Abdulrahuf7775/FinalYearProject/turnitin_report/DESIGN AND IMPLEMENTATION OF A MULTI-SENSOR SOIL MONITORING AND LORA COMMUNICATION SYSTEM FOR PRECISION FARMING APPLICATIONS (1).pdf

SEET-Mechatronic Engineering

Final Year Projects 2026

MCE 599

## DESIGN AND IMPLEMENTATION OF A MULTI-SENSOR SOIL MONITORING AND LORA COMMUNICATION SYSTEM FOR PR…

# Abdulrauf Abdulrauf Olasunkanmi 2021/1/79550ET

Document Details

Submission ID
trn:oid:::1:3657835644

Submission Date
Sep 23, 2026, 1:09 PM GMT+1

Download Date
Sep 25, 2026, 6:26 PM GMT+1

File Name
DESIGN_AND_IMPLEMENTATION_OF_A_MULTI-SENSOR_SOIL_MONITORING_AND_LORA_COMMU….docx

File Size

### 4.0 MB

### 71 Pages

15,280 Words

87,166 Characters

Page 1 of 77 - Cover Page | Submission ID trn:oid:::1:3657835644
Page 1 of 77 - Cover Page | Submission ID trn:oid:::1:3657835644

## 5% Overall Similarity

The combined total of all matches, including overlapping sources, for each database.
Match Groups

### 52 Not Cited or Quoted 3%

Matches with neither in-text citation nor quotation marks

### 26 Missing Quotations 1%

Matches that are still very similar to source material

### 1 Missing Citation 0%

Matches that have quotation marks, but no in-text citation

### 0 Cited and Quoted 0%

Matches with in-text citation present, but no quotation marks

Top Sources

3% | Internet sources
3% | Publications
1% | Submitted works (Student Papers)
Page 2 of 77 - Integrity Overview | Submission ID trn:oid:::1:3657835644
Page 2 of 77 - Integrity Overview | Submission ID trn:oid:::1:3657835644

Match Groups

### 52 Not Cited or Quoted 3%

Matches with neither in-text citation nor quotation marks

### 26 Missing Quotations 1%

Matches that are still very similar to source material

### 1 Missing Citation 0%

Matches that have quotation marks, but no in-text citation

### 0 Cited and Quoted 0%

Matches with in-text citation present, but no quotation marks

Top Sources

3% | Internet sources
3% | Publications
1% | Submitted works (Student Papers)

Top Sources

The sources with the highest number of matches within the submission. Overlapping sources will not be displayed.

### 1 Internet

www.mdpi.com (https://www.mdpi.com/1424-8220/26/14/4381) | <1%

### 2 Publication

R.K. Naresh, Rajan Bhatt, Krishan K. Verma, Hari Om Katiyar, Arun Kumar, Mauro … (https://doi.org/10.1201/9781042052547) <1%

### 3 Publication

S. Kannadhasan, P. Sivakumar, Anegagregn Gashaw Ferede, Abraham Melkie Ted… (https://doi.org/10.1201/9781003598312) <1%

### 4 Publication

Md. Najmul Mowla, Neazmul Mowla, A. F. M. Shahen Shah, Khaled M. Rabie, Thok… (https://doi.org/10.1109/ACCESS.2023.3346299) <1%

### 5 Internet

www2.mdpi.com (https://www2.mdpi.com/2071-1050/14/2/827) | <1%

### 6 Internet

arxiv.org (https://arxiv.org/html/2409.11200v1) | <1%

### 7 Internet

ijaseit.insightsociety.org (https://ijaseit.insightsociety.org/index.php/ijaseit/article/view/18836) | <1%

### 8 Student papers

IT University of Copenhagen | <1%

### 9 Internet

www.suaire.sua.ac.tz (https://www.suaire.sua.ac.tz/server/api/core/bitstreams/3a597491-25bc-4f92-a3c6-7f9c52a5762f/content) | <1%

### 10 Publication

Suman Lata Tripathi, Om Prakash Kumar, Allwin Devaraj Stalin, Tanweer Ali. "Inn… (https://doi.org/10.1201/9781003724988) | <1%
Page 3 of 77 - Integrity Overview | Submission ID trn:oid:::1:3657835644
Page 3 of 77 - Integrity Overview | Submission ID trn:oid:::1:3657835644

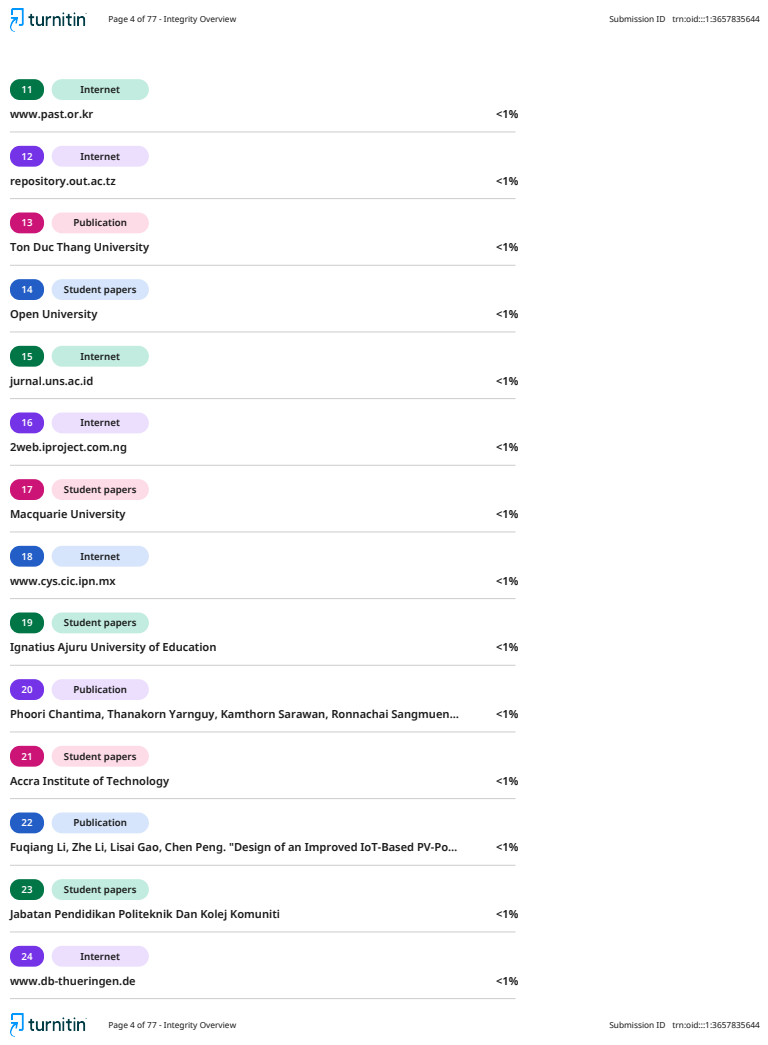
[picture p24: page 4]
11 Internet; www.past.or.kr; 12 Internet; repository.out.ac.tz; 13 Publication; Ton Duc Thang University; 14 Student papers; Open University; 15 Internet; jurnal.uns.ac.id; 16 Internet; 2web.iproject.com.ng; 17 Student papers; Macquarie University; 18 Internet; www.cys.cic.ipn.mx; 19 Student papers; Ignatius Ajuru University of Education; 20 Publication; Phoori Chantima, Thanakorn Yarnguy, Kamthorn Sarawan, Ronnachai Sangmuen…; 21 Student papers; Accra Institute of Technology; 22 Publication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

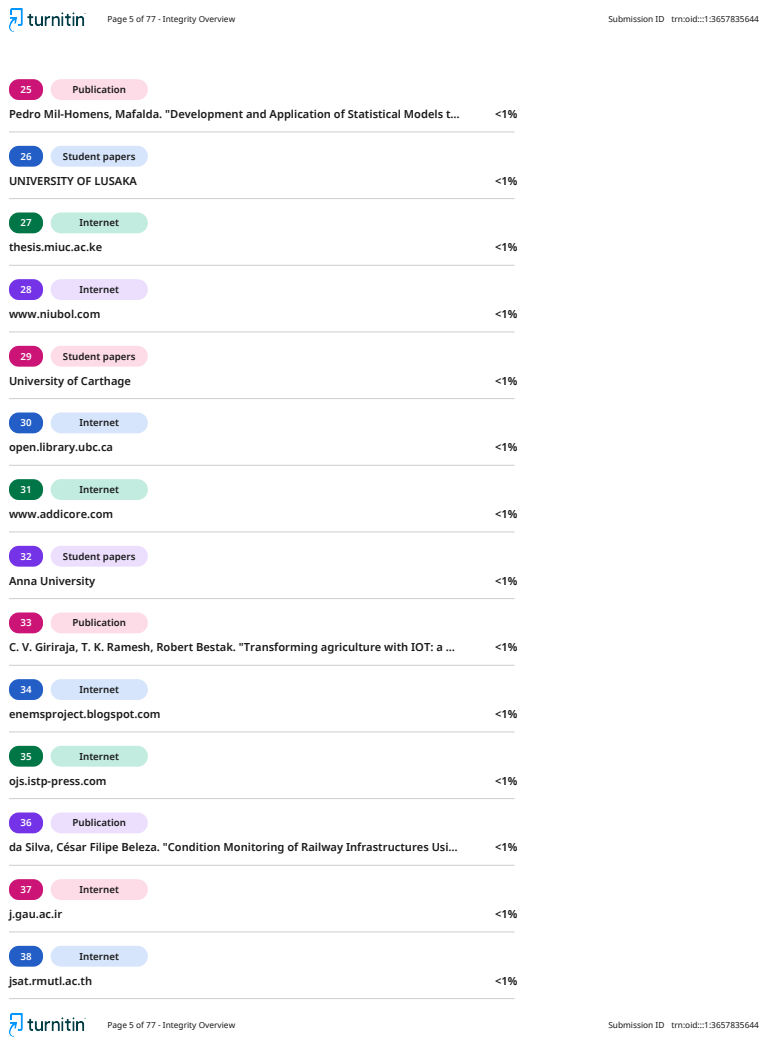
[picture p25: page 5]
25 Publication; Pedro Mil-Homens, Mafalda. "Development and Application of Statistical Models t…; 26 Student papers; UNIVERSITY OF LUSAKA; 27 Internet; thesis.miuc.ac.ke; 28 Internet; www.niubol.com; 29 Student papers; University of Carthage; 30 Internet; open.library.ubc.ca; 31 Internet; www.addicore.com; 32 Student papers; Anna University; 33 Publication; C. V. Giriraja, T. K. Ramesh, Robert Bestak. "Transforming agriculture with IOT: a …; 34 Internet; enemsproject.blogspot.com; 35 Internet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

### 39 Internet

mdpi-res.com (https://mdpi-res.com/d_attachment/electronics/electronics-11-00943/article_deploy/electronics-11-00943.pdf) | <1%

### 40 Internet

sciendo.com (https://sciendo.com/issue/EBTJ/1/4) | <1%

### 41 Internet

www.hackster.io (https://www.hackster.io/Klinsman21/two-arduinos-communicating-at-3km-distance-88fa0f) | <1%

### 42 Publication

Dave Emmanuel V. Nuada, Jerald M. Velonta, Christian Neri G. Tuazon, Jimuel Nyl… (https://doi.org/10.11591/ijeecs.v40.i3.pp1539-1548) | <1%
Page 6 of 77 - Integrity Overview | Submission ID trn:oid:::1:3657835644
Page 6 of 77 - Integrity Overview | Submission ID trn:oid:::1:3657835644

1

CHAPTER ONE

### 1.0 INTRODUCTION

### 1.1 Background of the Study

Agriculture is one of the key foundations of human civilisation. It helps to ensure food security,

economic growth and livelihoods globally. The Food and Agriculture Organisation of the United

Nations (“The State of Food and Agriculture 2025,” 2025) reports that the agriculture sector is a

source of employment for over two and a half billion people worldwide and the backbone of the

economies of developing countries. In sub-Saharan Africa the performance of agriculture has a

direct impact on the national levels of food sufficiency and poverty. But, with the population

explosion, climatic changes, soil degradation, and mismanagement of resources, there are

increasing challenges in agriculture(Singh et al., 2022).

Monitoring and management of soil health is important for food production, and many farming

communities are still not precise and effective at monitoring and managing soil conditions (Khanal

et al., 2024; Shahab et al., 2025). The farmers use traditional practices of soil sampling, laboratory

testing and farmer observation on a periodic basis to aid in irrigation and fertiliser decision-

making. All these | methods are time-consuming, | expensive, | and | unable | to | measure the soil

conditions at various locations within a field (Pawar & Deosarkar, 2023).This results in over-

irrigating or under-fertilising, which wastes water and chemicals for farmers. This also results in

increased production expenses, soil erosion, and harmful environmental impacts such as soil

pollution from nutrient run-off into water bodies (Khanal et al., 2024). In particular, many farmers

in developing areas are still using these antiquated techniques.

The problem of imprecise soil management can be solved by the concept of precision agriculture

with the help of Internet of Things (IoT) and Wireless Sensor Network (WSN) (Almufareh et al.,

1

16

2

2

33 35

Page 7 of 77 - Integrity Submission | Submission ID trn:oid:::1:3657835644
Page 7 of 77 - Integrity Submission | Submission ID trn:oid:::1:3657835644

2

2024; | Arshad | et al., 2022; | Križanović | et al., 2023). It employs real-time measurement and

monitoring of soil moisture, soil temperature, nutrient content and other variables to inform on-

site and time variable management of all production inputs. This is a substitute for blanket

practices, which are substituted with targeted interventions according to specific field conditions

(Placidi et al., 2021). These soil measurements are collected and transmitted by a sensor-based

system that utilises the Internet of Things (IoT), enabling timely decision-making by farmers and

systems to support them. It has been found that irrigation and fertilisation management based on

data can reduce water consumption by 20–40 percent and improve crop yields by 10–25 percent

over conventional practices (Placidi et al., 2021; Khanal et al., 2024). Several IOT soil monitoring

platforms have been designed and tested in the studies and found to be technically feasible (Arshad

et al., 2022).

However, there are still many challenges to be addressed in current soil monitoring systems using

IoT, particularly in remote and rural fields. Many of the solutions available rely on wireless

connectivity, either Wi-Fi or cellular; such connectivity is not always available or reliable in many

developing countries (Sen et al., 2024). Most of the sensors measure a single soil parameter, which

limits the ability to obtain a comprehensive picture of soil conditions required for optimal precision

farming decisions making (Pamungkas et al., 2023). One of the drawbacks is that most of the low-

cost systems lack GPS-based(Global Positioning System) spatial tagging features, which create

geo-referenced soil health maps useful for targeted application of soil health management

strategies for crop management (Pawar & Deosarkar, 2023). All these challenges make it difficult

for smallholder and remote farmers to obtain timely, comprehensive soil information.

The aim of this project is to develop a multi-sensor soil monitoring and LoRa communication

system to overcome these challenges for precision farming. The system is based on the use of an

2

10

Page 8 of 77 - Integrity Submission | Submission ID trn:oid:::1:3657835644
Page 8 of 77 - Integrity Submission | Submission ID trn:oid:::1:3657835644

3

ESP32 | microcontroller | as its central controller, an NPK(Nitrogen, Phosphorus and Potassium)

sensor and a GPS module to collect a wide variety of NPK and environmental parameters at each

of the sensor locations. Data is transmitted wirelessly via LoRa SX1278 transceiver with the

capability to transmit data over ranges in rural areas without requiring any cellular or internet

infrastructure. Each soil measurement is geographically tagged to the GPS module, enabling site-

specific soil health maps to be developed. It is a low cost, low power, plug-and-play system that

is ideal for Smallholder and Farms in Remote Areas in Developing Countries.

### 1.2 Problem Statement

The global population is increasing, arable land is decreasing and climate instability is a problem

for food production systems across the world (Pawar & Deosarkar, 2023). The traditional farming

methods that involve manual soil sampling, visual assessment, and equal water and fertiliser

application are not adaptable to the dynamics and variability of soil properties (Khanal et al.,

2024). They are imprecise, costly and environmentally damaging due to nutrient run-off and soil

compaction. The use of IoT-based precision farming technologies in developing countries and

rural remote regions with low population density is hindered by the continued technological,

infrastructural and financial challenges (Mansoor et al., 2025).

The main issue this project addresses is the lack of a reliable, multi-parameter, infrastructure-

independent soil monitoring system that can work well in remote farming areas. The current low-

cost soil sensors for IoT often use Wi-Fi and/or cellular communication technologies for data

transmission; however, these technologies are frequently unavailable or unreliable in the remote

agricultural areas of developing countries (Arshad et al., 2022; Aldhaheri et al., 2024; Placidi et

al., 2021). The lack of reliable internet infrastructure and power supply remains a primary

bottleneck for precision agriculture in Sub-Saharan Africa, such as in Nigeria (Song et al., 2026;

3

Page 9 of 77 - Integrity Submission | Submission ID trn:oid:::1:3657835644
Page 9 of 77 - Integrity Submission | Submission ID trn:oid:::1:3657835644

4

Lloret et al., 2021). The majority of the sensor nodes that are deployed measure only one soil

characteristic, such as moisture or temperature. Also existing low-cost systems lack GPS-based

geolocation, making it difficult to map soil conditions in a spatial manner which is important for

field zonation for different treatment (Pawar & Deosarkar, 2023). These constraints imply that the

farmers in remote areas are not able to receive the spatiotemporally complete and timely soil

information that they require for the purposes of precision farming.

### 1.3 Aim and Objectives

The aim of this project is to design and implement | multi-sensor | soil | monitoring and LoRa

communication system for precision farming applications.

The objectives of this project include the following:

i. To develop soil sensing nodes which will be able to sense multiple factors.

ii. To develop a wireless communication module utilising LoRa module which will transfer

sensed data to a gateway.

iii. To evaluate the performance of the developed system.

### 1.4 Significance of the Study

This study is a major step forward in the field of precision agriculture by addressing some of the

technological challenges that have hindered the use of soil monitoring devices in rural areas. The

development of a multi-sensor soil monitoring platform that is capable of operating over long

distances without the need of internet access for the farmers from underdeveloped countries is very

crucial. The system gives farmers the information they need to make fast, site-specific decisions

by providing real-time insight into a variety of soil characteristics, such as temperature, humidity,

moisture, and vital nutrients. The results of these studies have consistently shown that yield gains

of 10-25%, water savings of 20-40% and economical savings of 20-30% can be achieved through

2 2

19

Page 10 of 77 - Integrity Submission | Submission ID trn:oid:::1:3657835644
Page 10 of 77 - Integrity Submission | Submission ID trn:oid:::1:3657835644

5

data-driven irrigation and fertilisation management compared to conventional practices (Placidi et

al., 2021).

The proposed technology can help in sustainable agriculture by enabling accurate application of

resources which reduces the chances of fertiliser run-off and reduces unnecessary chemicals and

soil degradation. The advantage of the GPS-based spatial tagging is that detailed soil health maps

can be generated, which is an emerging practice in modern agronomy and is now becoming more

common, the use of precision zone management (Pawar & Deosarkar, 2023). This research offers

fresh insights into how multiple sensor data can be combined with the LoRa communication

system and how this data can be used for predictive analysis using artificial intelligence, providing

researchers and developers with a replicable approach for future smart farming solutions.

### 1.5 Scope of the Study

The project involves the design, development, and testing of a multi-sensor soil monitoring system

with LoRa radio wireless communication to support precision agriculture. Real-time soil moisture,

soil | temperature, | ambient | humidity, and | NPK | nutrient levels | (Nitrogen, Phosphorus, and

Potassium) can be acquired by the system. Each sensor node is equipped with a GPS module for

geographical tagging of collected data. The LoRa SX1278 module enables long-range wireless

data transmission of up to 15 kilometers in rural area, without the need for cellular or Wi-Fi

infrastructure. The system adopts a network topology, where multiple sensor nodes communicate

with a | single | central gateway | that sends and stores sensor data. The system is also designed to

interface with an AI-based predictive module for irrigation and fertilisation decision support.

The LoRa communication range may be reduced in environments with significant physical

obstructions such as dense vegetation or buildings.

1

34

42

Page 11 of 77 - Integrity Submission | Submission ID trn:oid:::1:3657835644
Page 11 of 77 - Integrity Submission | Submission ID trn:oid:::1:3657835644

6

The system | relies | on a rechargeable battery | and solar panel for operation. Extended periods of

cloudy weather or insufficient sunlight may reduce the battery charging efficiency and shorten the

operating time of the sensor node.

The AI-based prediction module relies on data trends over time and may not provide reliable

outputs during the initial period of deployment when insufficient historical data is available.

### 1.6 Organisation of Project

The report of this project is presented in five chapters. The introduction to the study which covers

background, problem statement, aim and objectives, significance, scope and definition of key

terms is presented in Chapter One. In Chapter Two, the literature survey on precision agriculture,

soil monitoring technologies, IoT sensor systems and LoRa communication is presented. The

research methodology used for the development of the system is discussed in Chapter Three, which

includes system architecture, hardware selection, circuit configuration and software

implementation. The results of the system testing and performance evaluation are presented and

discussed in Chapter Four. The report ends | with a summary of findings, | conclusions | and

recommendations for further research in Chapter Five.

### 1.7 Definition of Terms

a) ESP32 (Espressif Systems 32-bit Microcontroller): is a low-power microcontroller with

integrated Wi-Fi and Bluetooth capability, developed by Espressif Systems, that has a dual-

core architecture. The ESP32 is the main component of the soil sensor node in this project,

gathering sensor data, controlling the GPS tagging and arranging LoRa data exchange.

b) | LoRa (Long Range): Long-range, low power wireless | modulation. The long-range

communication capability of 2 to 15 kilometers in a rural area with a low power

13

3

10

26

41

Page 12 of 77 - Integrity Submission | Submission ID trn:oid:::1:3657835644
Page 12 of 77 - Integrity Submission | Submission ID trn:oid:::1:3657835644

7

consumption makes LoRa a perfect solution for agricultural IoT applications in rural areas

without cellular coverage.

c) NPK Sensor: The NPK Sensor is an electronic soil sensor that measures the concentration

of three macronutrient elements (Nitrogen (N), Phosphorus (P), Potassium (K)) in the soil.

These nutrients are | important metrics | for | soil fertility | and | crop health, and real-time

measurement of these nutrients is essential for precision farming and fertiliser application.

d) Precision Agriculture: A farm management strategy that utilises information technology,

sensor networks, and data analytics to optimise field-level agronomic decisions with

respect to crop, soil, and environmental conditions. Precision agriculture aims to maximise

crop yield and resource efficiency by enabling site-specific and time-specific management

of farming inputs.

e) Telemetry: Automatic measurement and wireless transmission of such measurements

from remote sensors to a receiving station for monitoring and analysis.

28

Page 13 of 77 - Integrity Submission | Submission ID trn:oid:::1:3657835644
Page 13 of 77 - Integrity Submission | Submission ID trn:oid:::1:3657835644

8

CHAPTER TWO

### 2.0 LITERATURE REVIEW

### 2.1 Chapter Introduction

The chapter reviews the body of knowledge that is used when designing this project. It starts with

the basics - what precision agriculture is, the relationship between soil health parameters and crop

productivity and how sensor-based systems using IoT technologies have been implemented to

overcome the gap between field condition and farm management. So, the review focuses on the

technology used in the system, which includes wireless sensor networks, wireless LoRa

communication, the ESP32 microcontroller, and the integration of GPS. The chapter ends in a

well-organised review of direct related implementations and a summary of the gaps that the review

identifies.

### 2.2 Precision Agriculture

The term "precision agriculture" gets used loosely, but its core idea is specific: “inputting the

correct input, at the correct rate, at the correct location, at the correct time” (Mansoor et al., 2025).

It is different from traditional farming where a farmer spreads the same amount of water or

fertiliser throughout a field irrespective of the requirement of the different zones in that field

(Almufareh et al., 2024; Mansoor et al., 2025). It was a concept that developed in the 1980s when

GPS was first introduced and when yield-mapping equipment was also available (Lloret et al.,

2021; Mansoor et al., 2025). The cost of precision agriculture and the potential benefits were not

aligned enough to be practically used by many smallholder and mid-scale farms, until the advent

of affordable IoT sensors and wireless communication in the 2010s (Pawar & Deosarkar, 2023;

Song et al., 2026). That barrier cost still exists, and that is the problem that this project addresses.

12

Page 14 of 77 - Integrity Submission | Submission ID trn:oid:::1:3657835644
Page 14 of 77 - Integrity Submission | Submission ID trn:oid:::1:3657835644

9

Data is the key to precision agriculture success. It needs to continually provide spatially referenced

measurements of the variables that control crop performance: soil moisture, temperature,

macronutrient concentrations, pH(Potential of Hydrogen), ambient humidity (Song et al., 2026).

These parameters do not display a consistent pattern throughout a field. Hectares of farm land can

have pockets of high clay portions directly next to well-drained sandy soils, and areas with

inadequate amounts of nitrogen alongside other areas that are sufficiently fertilised. Failure to

acknowledge this variability in a field entirely results in predictably sub-optimal results (Placidi et

al., 2021).

In precision agriculture, the field is subdivided into management zones, with the inputs applied

according to the measured conditions in each zone (Mansoor et al., 2025; Najdenko et al., 2024).

This approach of zones is entirely reliant on the quality and spatial density of the information

provided by the underlying sensors; if the number of sensors is limited or data is sparse or delayed,

the zones are too broad to be considered a significant improvement over the uniform approach

(Mansoor et al., 2025; Song et al., 2026). This is because the frequency of the monitoring system

is as important as the management strategy that is developed on top of the monitoring system

(Khanal et al., 2024; Shahab et al., 2025)

Precision agriculture is considered by | the Food and Agriculture Organization (FAO) | as | a | core

approach to sustainable intensification, which aims to boost agricultural output and food

production on existing farmland without causing additional environmental harm or a

corresponding rise in resource use (FAO, 2025). If the world's population keeps rising towards a

projected 10 billion by 2050 while the amount of productive arable land remains strictly limited

and dwindling, it puts the field in an entirely different light than just farm economics (Pawar &

Deosarkar, 2023; Shahab et al., 2025). It comes to the forefront exactly where the complex issues

2

Page 15 of 77 - Integrity Submission | Submission ID trn:oid:::1:3657835644
Page 15 of 77 - Integrity Submission | Submission ID trn:oid:::1:3657835644

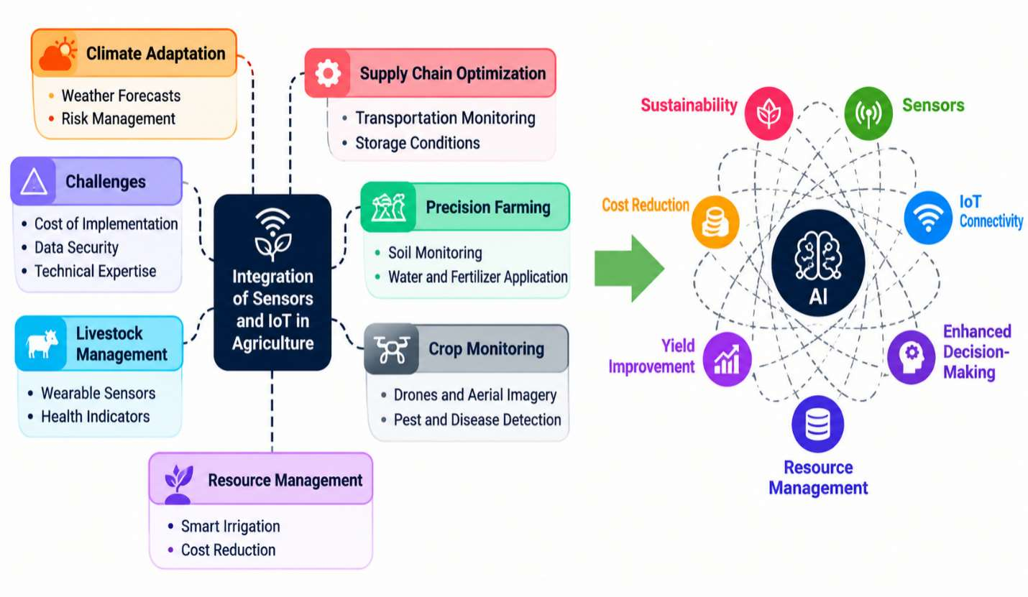
[picture p26: figure]

10

of global food security, environmental sustainability, and agricultural development policy intersect

(FAO, 2025; Mansoor et al., 2025). Consequently, leveraging precision technologies for

sustainable land management is no longer merely a commercial agricultural concern, but a critical

global development priority that underpins efforts to protect ecosystems, adapt to climate

instability, and achieve the United Nations' Sustainable Development Goals (FAO, 2025; Shahab

et al., 2025). Figure 2.1 illustrates | the integration of sensors | and IoT in precision agriculture,

highlighting their role in supporting efficient and data-driven farming practices (Mansoor et al.,

2025).

Figure 2.1 Integration of Sensors and IoT in Precision Agriculture(Mansoor et al., 2025)

### 2.3 Soil Parameters and Their Agronomic Significance

Soil is not an inert growing medium; it is a highly dynamic system, and the parameters that define

its state at any particular time directly affect a crop's productivity (Shahab et al., 2025). Knowing

which parameters are important and why they fluctuate is essential to the design of a precision

37

18

Page 16 of 77 - Integrity Submission | Submission ID trn:oid:::1:3657835644
Page 16 of 77 - Integrity Submission | Submission ID trn:oid:::1:3657835644

11

monitoring system. The following subsections detail the primary variables affecting crop

production that this system aims to monitor.

### 2.3.1 Soil Moisture

Of the variables affecting crop production, water availability is by far the most critical in the short

term. Water and dissolved nutrients are taken up by the roots, and when the water content in the

soil drops below the specific "wilting point" for a plant, growth slows, and yield loss can occur

within days (Chereches et al., 2024). However, excess watering is equally problematic; excessive

moisture in the soil reduces oxygen availability around the roots, leading to anaerobic conditions

that benefit pathogenic bacteria and increase nutrient loss from the soil (Pawar & Deosarkar, 2023).

Traditional irrigation scheduling is generally based on calendar or evapotranspiration estimates,

both of which are merely proxies for what physical sensors can measure. With real-time moisture

data, irrigation can be triggered by current field moisture conditions rather than estimates,

successfully saving water without compromising yield (Sen et al., 2024). To address this

efficiently, recent implementations have successfully utilised low-cost capacitance-based soil

moisture sensors with specialised modelling to accurately read volumetric water content across

various soil types (Placidi et al., 2021).

### 2.3.2 Soil Temperature

Soil temperature affects the germination rates, rooting, efficiency of nutrient uptake, and microbial

activity (Pawar & Deosarkar, 2023; Shahab et al., 2025). For most crops, there is a critical

temperature range before and after which root formation and nutrient uptake are effective, and

higher or lower than this range even with sufficient moisture and nutrient may have negative

impacts on normal plant performance (Shahab et al., 2025). The monitoring of temperature in

Page 17 of 77 - Integrity Submission | Submission ID trn:oid:::1:3657835644
Page 17 of 77 - Integrity Submission | Submission ID trn:oid:::1:3657835644

12

addition to moisture allows a management system to consider these interactions, rather than

assuming they operate independently of each other (Khanal et al., 2024).

### 2.3.3 Ambient Humidity

The relative humidity (RH) of the air above the crop canopy directly influences the crop's

transpiration rate, and consequently, the rate of decrease in soil moisture. Increased ambient

humidity reduces transpiration and water loss, whereas decreased humidity accelerates them

(Placidi et al., 2021). The inclusion of ambient humidity in the sensing suite makes irrigation

scheduling substantially more accurate than relying on soil moisture data alone, as it accounts for

one of the major atmospheric factors contributing to changing field conditions (Khanal et al.,

2024).

Ambient humidity is one of the most important factors that influence the overall evapotranspiration

rate, which is one of the most important factors used for calculating the actual crop water demand

and for scheduling the exact irrigation event (Singh et al., 2022). This ability to monitor variations

in air humidity in addition to temperature, continuously makes the IoT system very "climate-

adaptive," such that it can automatically adapt watering schedules to prevent water stress in plants

due to very dry air (Sen et al., 2024).

Knowledge of the ambient humidity is important for plant physiology, as leaf growth,

photosynthesis and pollination rates may be severely affected by a growth of plants in dry

conditions, leading to the death of delicate plant structures (like sepals or flowers) before reaching

maturity (Placidi et al., 2021). Consequently, feeding real-time humidity data into an automated

decision-making algorithm enables the system to forecast evaporation trends dynamically. This

ensures that the water distributed to the root zone precisely matches the fluctuating atmospheric

12

Page 18 of 77 - Integrity Submission | Submission ID trn:oid:::1:3657835644
Page 18 of 77 - Integrity Submission | Submission ID trn:oid:::1:3657835644

13

demands above ground, optimising resource use while safeguarding crop health (Sen et al., 2024;

Singh et al., 2022).

### 2.3.4 Soil Fertility and Macronutrients (NPK)

Soil fertility is mainly governed by the macronutrients (Nitrogen, Phosphorus ,Potassium) and

each one has a different role in the physiology of the plants. Nitrogen is key to protein production

and vegetative growth, deficiency causes yellowing leaves and slow growth, and excess causes

luxuriant leaves while restricting root and fruit production (Shahab et al., 2025). Phosphorus

stimulates root growth, flowering and seed production, especially in early growth of most crops.

Potassium is involved in water control in plant cells, resistance to diseases and enhancing fruit

quality, and under potassium deficiency plant is highly vulnerable to drought stress (Perdana et

al., 2024). Figure 2.2 illustrates common symptoms associated with nutrient deficiencies in plants,

providing a visual representation of how nutrient imbalance can affect plant development (Shahab

et al., 2025).

The traditional way of assessing NPK is laboratory testing of soil samples, which can take days to

weeks, and requires financial resources that many smallholder farmers in developing countries just

do not have. The readings of electronic NPK sensors based on the ion-selective electrode method

are obtained within seconds. In soil fertility monitoring, the accuracy of electronic multi-sensor

NPK measurements compared to the laboratory results was tested and proven to be sufficient for

implementation in precision farming (Pamungkas et al., 2023).

Page 19 of 77 - Integrity Submission | Submission ID trn:oid:::1:3657835644
Page 19 of 77 - Integrity Submission | Submission ID trn:oid:::1:3657835644

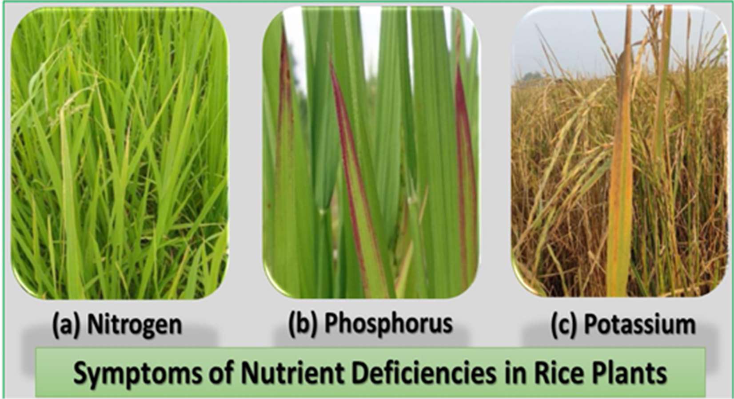
[picture p27: figure]

14

Figure 2.2: Symptoms of Nutrient Deficiencies in Plant (Shahab et al., 2025)

### 2.4 Wireless Sensor Networks in Agriculture

A Wireless Sensor Network consists of | a group of | spatially distributed | sensor | nodes | which

communicate wirelessly to gather and share data (Križanović et al., 2023). Agricultural WSNs

have constraints that are not found in most industrial and urban deployments: power consumption,

since nodes are placed on batteries and are required to power them for a long time without

maintenance (Aldhaheri et al., 2024; Patrizi et al., 2022); long communication range, since the

fields are large (Aldhaheri et al., 2024); and outdoor reliability in the presence of rain, temperature

variation, and dense vegetation (Lloret et al., 2021; Mansoor et al., 2025).

Different WSNs use different communication technology, hence, different constraints can be

satisfied for each type. Wi-Fi achieves high data rates and has a range of tens of metres at best,

and consumes too much power for battery-powered field nodes (Arshad et al., 2022). GSM(Global

System for Mobile Communications) and cellular networks offer range but need infrastructure,

power usage higher than LPWAN (Low-Power Wide-Area Network) and | SIM and | data | costs
(Mansoor | et al., 2025). All of those are not well suited to the range, power efficiency and

infrastructure independence needed for remote agricultural monitoring.

11

8

Page 20 of 77 - Integrity Submission | Submission ID trn:oid:::1:3657835644
Page 20 of 77 - Integrity Submission | Submission ID trn:oid:::1:3657835644

15

This is where low-power wide-area network (LPWAN) technologies come in. They sacrifice data

rate because agricultural sensor data doesn't require it as often, and since it's small packets that are

being sent (Aldhaheri et al., 2024). A soil monitoring node sending a few dozen bytes every few

minutes doesn't need bandwidth; it needs to reach a gateway kilometers away without draining its

battery in a week.

### 2.4.1 LoRa and LoRaWAN Technology

Spread-spectrum modulation technique developed by Semtech, which uses unlicensed sub GHz

frequency bands called LoRa (Long Range). The modulation technique is what makes it special

(Križanović et al., 2023). LoRa employs Chirp Spread Spectrum (CSS) that encodes data into

sweeps of frequencies over a given bandwidth. The received signal level for CSS signals is well

below the noise floor, which is not possible with conventional narrow band modulation (Singh et

al., 2022).

LoRa operates in open, rural areas that either have line of sight or near line of sight between a node

and a gateway and can transmit in the milliwatt power range between 2 and 15 kilometers from a

node to a gateway. In the urban context, range is heavily restricted by the presence of buildings

and roads, whereas it is not in rural conditions, which is pertinent to this context (Križanović et

al., 2023).

The SX1278 transceiver is used to process the physical layer and communication protocol between

the sensor node and the gateway is realised through the firmware program without deploying the

complete LoRaWAN(Long Range Wide-Area Network) layer. This eliminates any need for

network server infrastructure and ensures a simple implementation, matching the system's design

needs (Placidi et al., 2021).

22

4

8

Page 21 of 77 - Integrity Submission | Submission ID trn:oid:::1:3657835644
Page 21 of 77 - Integrity Submission | Submission ID trn:oid:::1:3657835644

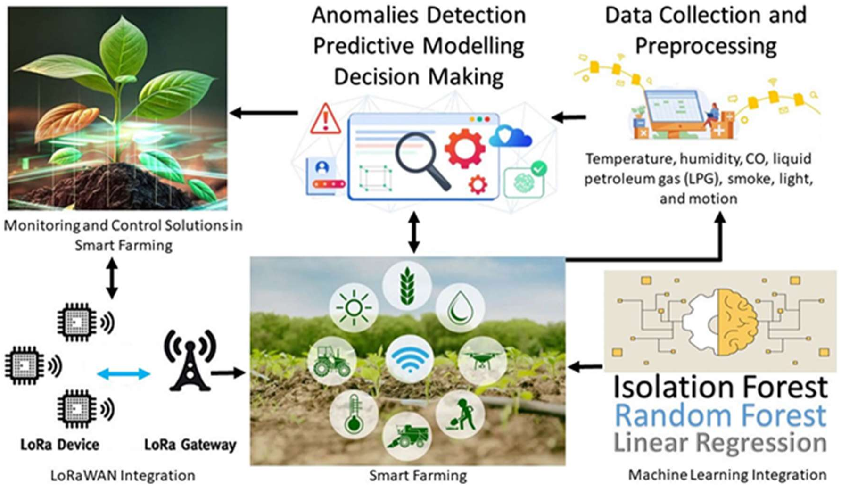
[picture p28: figure]

16

Arshad et al. (2022) deployed a LoRaWAN-based smart agriculture decision support system in

several field nodes and tested communications performance as well as agronomic results

throughout the entire growing season. The architecture and operational concept of the proposed

device are presented in Figure 2.3. And the conclusions that they draw are that LoRa can be relied

upon to provide reliable real time information in rural agricultural contexts and the data yielded

by LoRa can lead to significantly improved irrigation and fertilisation decisions over traditional

management practices on the same farm.

Figure 2.3: An intelligent LoRaWAN-based IoT device for monitoring and control solutions in smart farming Arshad et al. (2022).

### 2.4.2 GPS Integration for Spatial Soil Mapping

In a fixed-node deployment, the GPS coordinate is a static metadata tag that is attached to the

measurements that the node transmits; it tells the data management system exactly which field

location each one of these measurements refers to. Where the nodes are repositioned or moved

11

32

Page 22 of 77 - Integrity Submission | Submission ID trn:oid:::1:3657835644
Page 22 of 77 - Integrity Submission | Submission ID trn:oid:::1:3657835644

17

through a field, it becomes a mobile or semi-mobile deployment and the coordinate is a variable

to be recorded at each reading, ensuring the data is spatially coherent (Arshad et al., 2022).

If soil data is georeferenced with GPS coordinates, it can be displayed as a soil health map – a

layer in the georeferenced map format that depicts the moisture, temperature or NPK levels of soil

throughout the field. These maps form the basis for management zone delineation, which involves

multiple irrigation/fertiliser management plans for different management zones depending on

irrigation (or fertiliser) needs measured versus assumed (Pawar & Deosarkar, 2023). Readings

from a network of nodes can be a stack of disconnected numbers without spatial referencing, but

with spatial referencing they can become a map that illustrates a pattern that a single point reading

could not (Aldhaheri et al., 2024).

Singh et al. (2022) combine LoRa with GPS based soil and weather monitoring technologies and

project spatial information onto maps, which are then used to guide variable-rate irrigation

application on the field. Their findings indicate that with careful analysis of the data, GPS tagged

data from a small number of field nodes can yield important spatial insights that can be acted upon,

a result that backs the integration of GPS in this project.

### 2.5 Review of Related Works

This section summarises specific applications found in the recent literature that are directly

comparable to the system proposed in this project, in particular, the systems where multi-sensor

soil measurements are coupled with LoRa or LPWAN communication.

Shahab | et al. (2025) | presented | a real-time IoT monitoring system | intended | to | support crop-

management decisions in rice fields. The system used an 8-in-1 soil sensor connected to a cloud

platform over Wi-Fi, and it automatically generated fertiliser and irrigation recommendations from

the sensor readings. Its strength lies in demonstrating that automated, sensor-driven decision

3

Page 23 of 77 - Integrity Submission | Submission ID trn:oid:::1:3657835644
Page 23 of 77 - Integrity Submission | Submission ID trn:oid:::1:3657835644

18

support can be delivered directly to farmers in a usable form. However, the system depends entirely

on Wi-Fi and a mobile-hotspot internet connection, which is unreliable or unavailable in the

remote, unconnected farmland this project targets; this limitation is a key justification for adopting

long-range LoRa communication instead of Wi-Fi in the proposed system.

Aldhaheri et al. (2024) conducted a comprehensive literature review of LoRa-based agricultural

networks under the Agriculture 4.0 paradigm, examining the opportunities, challenges and future

directions of the technology. The review's strength is its broad synthesis of evidence confirming

that LoRa's long communication range and low power consumption make it an efficient wireless

option for precision farming, which supports the communication technology chosen for this

project. Its main limitation, however, is that it is a survey rather than an implemented system: it

does not deploy or evaluate an actual multi-sensor soil node, leaving an empirical gap that the

hardware design and field testing of this project are intended to fill.

Chereches et al. (2024) designed and calibrated a low-cost, multi-point soil moisture monitoring

system that used twenty-eight capacitive sensors wired to an Arduino Mega 2560 through

multiplexers, in order to assess irrigation efficiency across a field. The strength of this work is its

demonstration of dense, spatially distributed moisture sensing at low hardware cost, which is a

useful reference for sensor calibration practice. Its limitation, in relation to the problem this project

addresses, is that the system is restricted to moisture sensing over wired multiplexed connections,

with no wireless communication and no macronutrient (NPK) detection; this justifies the wireless,

multi-parameter sensing approach adopted here.

Patrizi et al. (2022) developed a solar-powered sensor node that transmitted environmental data

over Wi-Fi and applied a Long Short-Term Memory (LSTM) deep-learning model to produce a

“virtual” soil moisture sensor, estimating moisture without a dedicated physical moisture probe. A

3

1

4

Page 24 of 77 - Integrity Submission | Submission ID trn:oid:::1:3657835644
Page 24 of 77 - Integrity Submission | Submission ID trn:oid:::1:3657835644

19

strength of this study is its validation of solar power as a viable, extended-life energy source for

field sensor nodes, an approach this project also adopts. The limitation, however, is that the system

relies on Wi-Fi connectivity and on a modelled, virtual estimate of moisture rather than direct

physical sensing of soil nutrients; this underlines the need, addressed in this project, for direct

physical NPK measurement delivered over a long-range LoRa link rather than a modelled proxy

over Wi-Fi.

Almufareh et al. (2024) built | an intelligent LoRaWAN-based IoT monitoring | framework that
applied an Isolation Forest | unsupervised machine-learning | algorithm | to detect anomalies in

temperature and humidity readings from farm sensor nodes. Its strength is in showing that

LoRaWAN links can reliably carry sensor data of sufficient quality to support machine-learning-

based anomaly detection, which is encouraging for the data-quality requirements of this project.

Its limitation is that the work is confined to environmental anomaly detection in temperature and

humidity, with no NPK sensing and no GPS-based spatial tagging, both of which are central to the

soil-nutrient mapping problem this project sets out to solve.

Kumar (2025) implemented an automated, Arduino-based multi-sensor farming platform that

combined soil moisture, temperature and ultrasonic sensors to control irrigation pumps and to raise

alerts on animal intrusion. The strength of this system is its practical demonstration of closed-loop

automation, linking sensing directly to actuation and alerting. Its limitation is the absence of any

long-range wireless communication technology such as LoRa and the absence of dedicated NPK

sensing, restricting the platform to short-range, wired operation on a single plot; this directly

justifies the integration of long-range LoRa communication and macronutrient sensing in the

system proposed here.

25

25

Page 25 of 77 - Integrity Submission | Submission ID trn:oid:::1:3657835644
Page 25 of 77 - Integrity Submission | Submission ID trn:oid:::1:3657835644

20

Khanal et al. (2024) developed an ESP32S3-based soil health monitoring system capable of

measuring soil moisture, pH, UV exposure and NPK levels, and transmitting the data in real time

over Wi-Fi, GSM or LoRa. This is one of the closest functional precedents to the present project

because it combines NPK sensing with an optional LoRa transmission path, and its strength lies in

proving that multi-parameter soil-nutrient sensing can be paired successfully with LPWAN

communication. Its limitation is the absence of integrated GPS functionality, so the readings

cannot be tied to precise field locations or used to build a spatial soil-health map; supplying that

missing GPS-based spatial referencing is a core objective of this project.

Križanović et al. (2023) designed an energy-efficient, LoRa-based multi-sensor wireless sensor

network that used deep-sleep scheduling on an ESP32 microcontroller to extend node battery life,

and separately carried out a thorough field evaluation of LoRa performance in agricultural settings,

measuring packet delivery ratio and signal strength across different distances and spreading

factors. The strength of this work is the depth of its empirical characterisation of LoRa link

performance and power-saving scheduling, both of which directly inform the duty-cycling and

link-budget decisions made in this project. Its limitation is that it monitors only general

environmental parameters and does not incorporate NPK sensing or GPS tagging, leaving the

nutrient- and location-aware monitoring problem unresolved.

Pamungkas et al. (2023) investigated the accuracy of a LoRa-based soil fertility monitoring system

built around three electronic NPK sensors, comparing their readings against standard laboratory

soil analysis. The strength of this study is that it provides direct empirical validation that low-cost

electronic NPK sensors can approach laboratory-level accuracy for practical precision-farming

use, which supports the feasibility of the 7-in-1 NPK sensor selected for this project. Its limitation

is the calibration drift and measurement deviation the electronic sensors exhibited over extended

23

6

Page 26 of 77 - Integrity Submission | Submission ID trn:oid:::1:3657835644
Page 26 of 77 - Integrity Submission | Submission ID trn:oid:::1:3657835644

21

use, and the absence of GPS integration; these findings motivate the calibration routine and the

spatial (GPS-based) tagging built into the system proposed here.

Perdana | et al. | (2024) | developed a real-time, | IoT-based | NPK | detection | device, built around a

commercial RS-485 macronutrient sensor and a LoRa RFM95 module, that produced dynamic

fertiliser recommendations and was reported to significantly increase soybean yield in field trials.

Its strength is the demonstrated real-world agronomic benefit of combining NPK sensing with

LoRa transmission, and its published calibration data are directly applicable to the sensor

configuration used in this project. Its limitation is the absence of GPS integration, so soil-nutrient

conditions cannot be tracked or mapped geographically across an expansive farm; closing that

specific gap is one of the express aims of the system proposed here.

A. K. K. N. et al. (2024) proposed a smart NPK monitoring and control system built on an ESP32
microcontroller | that integrated NPK | and | moisture | sensors | to continuously assess soil hydration

and macronutrient status, driving an automated fertiliser dispenser. The strength of the system is

its closed-loop automation, moving directly from sensing to fertiliser dispensing without manual

intervention. Its limitation is that it relies exclusively on the ESP32's native Wi-Fi connectivity,

with no long-range LoRa module and no GPS, making it unsuitable for large or remote agricultural

fields lacking reliable internet coverage, precisely the operating condition this project is designed

to address through LoRa communication.

Song et al. (2026) carried out a systematic literature review of multi-type soil-sensing

technologies, synthesising the critical trade-offs among sensor cost, technological maturity and

ecological impact across the field. Its strength is the broad technological landscape it maps out,

which helps justify the specific sensor choices made in this project, including the selection of a 7-

in-1 NPK sensor as a mature, cost-effective option. Being purely a review, its limitation is that it

3 3

10

Page 27 of 77 - Integrity Submission | Submission ID trn:oid:::1:3657835644
Page 27 of 77 - Integrity Submission | Submission ID trn:oid:::1:3657835644

22

analyses adoption bottlenecks and technology trends without performing any physical engineering,

design or field testing of a novel multi-sensor LoRa system, a gap that the implementation phase

of this project directly addresses.

Arshad et al. (2022) implemented a solar-powered, GPS-equipped sensing node carrying NPK,

moisture and pH sensors that transmitted data over LoRaWAN to a cloud-based Decision Support

System supporting automated irrigation; the reported outcome was increased crop yield and

reduced water use compared with conventional management. This is the most structurally

complete precedent identified in the literature, as it combines solar power, GPS, multi-parameter

NPK sensing and LoRaWAN communication in a single validated node, and its strength lies in

demonstrating measurable agronomic benefit from exactly this combination of technologies. Its

limitation, as the authors themselves note, is that the prototype works reliably only in limited areas

and cannot extract data from encrypted sensors, indicating a need for further hardware optimisation

and more robust field testing, the kind of refinement this project sets out to provide.

Pawar and Deosarkar (2023) produced an exhaustive review of Internet-of-Things communication

technologies | for | smart agriculture, | concluding that | Low-Power Wide-Area Network (LPWAN)

protocols, LoRa in particular, are best suited to agricultural use because of their minimal power

requirements and extended communication range. Its strength is the comparative rigour with which

it weighs LoRa against alternative wireless standards, offering an authoritative justification for the

communication technology adopted in this project. Its limitation is that, as a literature survey, it

does not physically engineer or test a multi-sensor hardware node for real-time soil NPK

monitoring, which is exactly the practical contribution this project makes.

Najdenko et al. (2024) reviewed and categorised commercially available and experimental in-field

soil-analysis tools and proximal sensing methods, comparing approaches to the real-time mapping

5

4

5

Page 28 of 77 - Integrity Submission | Submission ID trn:oid:::1:3657835644
Page 28 of 77 - Integrity Submission | Submission ID trn:oid:::1:3657835644

23

of soil pH, nitrate, phosphorus and potassium. Its strength is the comprehensive, state-of-the-art

catalogue of nutrient-sensing technologies it provides, which is useful for justifying and situating

the sensor choice made in this project. Its limitation is that it remains a technological survey rather

than a proposal for a new, integrated IoT hardware system using LoRa communication, leaving

room for the practical implementation this project undertakes.

Saban et al. (2023) developed a smart agricultural system that combined LoRa and LoRaWAN

connectivity with Programmable Logic Controllers (PLCs) and a cloud-based web application,

enabling remote environmental monitoring and task automation through a multi-node architecture

with a central gateway. Its strength is the gateway and multi-node network design it demonstrates,

which is a useful reference for the network architecture of this project. Its limitation is that it is

oriented toward general environmental monitoring and food-storage automation rather than in-situ

soil-nutrient tracking, and the system is neither GPS-tagged nor NPK-monitored, gaps this

project's soil-monitoring focus is designed to close.

Lloret et al. (2021) designed a low-cost, group-based wireless sensor network using inductive-coil

soil moisture sensors to automate and control smart irrigation according to crop water

requirements. Its strength is the cost-effective, scalable network deployment model it demonstrates

for coordinating groups of sensor nodes. Its limitation is that the network architecture is dedicated

exclusively to moisture-based irrigation control, entirely omitting multi-sensor NPK macronutrient

sensing and long-range LoRaWAN integration, both of which this project incorporates.

Singh et al. (2022) developed a smart soil and weather monitoring system built on a single LoRa

communication platform that combined multi-parameter environmental sensing with spatial data

collection. Among all the works reviewed, this is the most structurally similar to the system

proposed here, since it unifies wireless communication, multi-parameter sensing and location-

Page 29 of 77 - Integrity Submission | Submission ID trn:oid:::1:3657835644
Page 29 of 77 - Integrity Submission | Submission ID trn:oid:::1:3657835644

24

aware data collection on one platform, which strongly supports the architectural approach of this

project. Its limitation is that it was designed to monitor weather-related parameters rather than soil

macronutrients, so it does not address the NPK-monitoring problem this project focuses on.

Rafi et al. (2025) designed FieldNet, an IoT framework for agricultural automation that integrates

LoRa communication, distributed sensor data gathering and AI-driven predictive decision-making.

Its strength is that it represents one of the most extensive and recent treatments of LoRa-based

precision agriculture combined with artificial intelligence, and its documented communication-

range performance and AI-integration approach inform the design choices made in this project. Its

limitation is that, as a general automation framework, it is not described with a dedicated, GPS-

tagged, multi-sensor NPK soil node, so it stops short of the specific spatial soil-nutrient monitoring

problem this project is built to solve.

Taken together, the reviewed literature clusters into four broad groups: systems that perform

generic environmental sensing (moisture, temperature, humidity) over Wi-Fi or GSM links that

are unreliable in remote farmland; systems that sense NPK macronutrients but lack GPS-based

spatial tagging, so their readings cannot be assembled into a field-level soil-health map; systems

that combine GPS and LoRa communication but without direct NPK sensing; and literature

reviews that justify these technologies conceptually without producing and field-testing an

integrated hardware system. None of the reviewed works combine a 7-in-1 NPK sensor, GPS-

based location and timestamp tagging, long-range LoRa communication and solar-powered

extended operation within a single validated soil-monitoring node. This gap is precisely what the

multi-sensor soil monitoring and LoRa communication system designed and implemented in this

project addresses.

Page 30 of 77 - Integrity Submission | Submission ID trn:oid:::1:3657835644
Page 30 of 77 - Integrity Submission | Submission ID trn:oid:::1:3657835644

25

### 2.5.1 Summary of Reviewed Works

Table 2.1: Table of Reviewed Works

Reference | Title / Focus | Methodology and Result | Limitation / Relevance
H. Shahab
et al., 2025 | Real-time IoT
| monitoring system
| for decision-making
| in rice crops. | The researchers developed
| | an IoT-based
| | environmental monitoring
| | system using an 8-in-1 soil
| | sensor connected to a
| | cloud platform via Wi-Fi
| | to provide automated
| | fertiliser and irrigation
| | recommendations for rice
| | fields.

The system relies heavily

on Wi-Fi and internet

connectivity via a mobile

hotspot, justifying the

need for my proposed

system to utilise long-

range LoRa

communication for

remote, unconnected

farming environments.

L.

Aldhaheri et

al., 2024

LoRa

Communication for

Agriculture 4.0:

Opportunities,

Challenges, and

Future Directions.

The study presents a

comprehensive literature

review of LoRa-based

agricultural networks,

concluding that LoRa's

long-range and low-power

capabilities make it a

highly efficient solution for

precision farming.

The study lacks the

empirical deployment of

a multi-sensor soil node,

establishing a gap for my

practical hardware design

project.

6

Page 31 of 77 - Integrity Submission | Submission ID trn:oid:::1:3657835644
Page 31 of 77 - Integrity Submission | Submission ID trn:oid:::1:3657835644

26

I. A.

Chereches et

al., 2024

Designing and

Calibration of a

Low-Cost Multi-

Point Soil Moisture

Monitoring System

for Precision

Agriculture.

The study developed a

multi-point soil moisture

monitoring system utilising

### 28 low-cost capacitive

sensors connected to an

Arduino Mega 2560 board

through multiplexers to

assess irrigation efficiency

The implemented system

focuses entirely on

moisture sensing via

wired connections,

lacking wireless LoRa

communication and NPK

nutrient detection, which

justifies the multi-sensor

wireless approach of my

proposed system.

G. Patrizi et

al., 2022

A Virtual Soil

Moisture Sensor for

Smart Farming

Using Deep

Learning.

The researchers developed

a solar-powered sensor

node transmitting

environmental data over

Wi-Fi and applied an

LSTM-based deep learning

algorithm to create a

virtual soil moisture

sensor.

The system relies on Wi-

Fi communication and

estimates moisture

virtually instead of

utilising physical multi-

sensor hardware for direct

NPK nutrient sensing,

demonstrating the need

for my proposed LoRa-

based physical

monitoring system.

1

22

24

Page 32 of 77 - Integrity Submission | Submission ID trn:oid:::1:3657835644
Page 32 of 77 - Integrity Submission | Submission ID trn:oid:::1:3657835644

27

M. F.

Almufareh

et al., 2024

Intelligent

LoRaWAN-based

IoT device for

anomaly detection in

farming.

The researchers developed

an intelligent LoRaWAN-

based IoT monitoring

framework that integrates

Isolation Forest

unsupervised machine

learning to accurately

detect anomalies in

temperature and humidity

data.

The study focuses

exclusively on

environmental anomaly

detection for temperature

and humidity, lacking the

specific multi-sensor

integration needed for

direct soil NPK

monitoring that my

project proposes.

R. Kumar,

2025

Integrated Multi-

Sensor Embedded

Platform for

Automated Precision

Farming.

The author implemented an

automated Arduino-based

farming platform that uses

soil moisture, temperature,

and ultrasonic sensors to

control water pumps and

provide animal intrusion

alerts.

The system does not

utilise long-range

wireless communication

technologies like LoRa or

specific sensors for

detecting NPK levels,

directly justifying the

integration of these

features in my proposed

design.

K. Khanal et

al., 2024

IoT-Based Real-

Time Soil Health

Monitoring System

The researchers developed

an ESP32S3-based system

capable of measuring soil

While the system

monitors NPK and

utilises LoRa, it lacks

Page 33 of 77 - Integrity Submission | Submission ID trn:oid:::1:3657835644
Page 33 of 77 - Integrity Submission | Submission ID trn:oid:::1:3657835644

28

for Precision

Agriculture.

moisture, pH, UV, and

NPK levels, transmitting

real-time data via Wi-Fi,

GSM, or LoRa protocols to

a central server.

integrated GPS

functionality for the

precise spatial mapping

of soil health across large

fields, which my

proposed system will

feature

V.

Križanović

et al., 2023

An Advanced

Energy-Efficient

Environmental

Monitoring in

Precision

Agriculture Using

LoRa-Based

Wireless Sensor

Networks.

The authors evaluated

LoRaWAN wireless sensor

networks through field

measurements and

simulations to determine

optimal communication

parameters for reliable,

energy-efficient data

transmission in precision

agriculture.

The study focuses heavily

on network energy

profiling and transmission

parameters rather than the

physical hardware

integration of a multi-

sensor node for soil NPK

tracking, validating my

focus on hardware

development.

W.

Pamungkas

et al., 2023

Research in

electronic multi-

sensor accuracy in

the implementation

of soil fertility

The study developed a

LoRa-based soil fertility

monitoring system using

three electronic NPK

sensors, comparing their

accuracy and standard

The electronic sensors

showed significant

measurement deviations

from laboratory results,

indicating a critical need

for improved multi-sensor

7

14

Page 34 of 77 - Integrity Submission | Submission ID trn:oid:::1:3657835644
Page 34 of 77 - Integrity Submission | Submission ID trn:oid:::1:3657835644

29

monitoring system

using LoRA.

deviation against standard

laboratory soil tests.

calibration and GPS

integration, which my

project aims to address.

D. Perdana

et al., 2024

Development of an

IoT-Based Device

for Real-Time

Detection of Soil

NPK Nutrient

Content to Optimise

Soybean Yields.

The authors implemented a

real-time IoT detection

system using an NPK

sensor and a LoRa RFM95

module to provide dynamic

fertiliser recommendations,

significantly increasing

soybean yields.

Although the system

utilises LoRa for NPK

monitoring, it does not

incorporate GPS

integration for

geographically tracking

soil conditions across

expansive farming plots,

highlighting a specific

gap my system will fill.

A. K. K. N.

et al., 2024

Smart NPK

Monitoring and

Control System for

Precision

Agriculture.

The study proposes an

ESP32 microcontroller-

based monitoring

framework integrating

NPK and moisture sensors

to continuously assess soil

hydration and

macronutrient levels for

automated fertiliser

dispensing.

The developed system

relies exclusively on the

ESP32's native Wi-Fi

connectivity without

integrating a long-range

LoRa communication

module, making it

unsuitable for vast

agricultural fields lacking

internet coverage.

15

Page 35 of 77 - Integrity Submission | Submission ID trn:oid:::1:3657835644
Page 35 of 77 - Integrity Submission | Submission ID trn:oid:::1:3657835644

30

W. Song et

al., 2026

Soil Sensors in

Smart Agriculture:

Multi-Type

Monitoring

Technologies and

Ecological

Development

Pathways.

This systematic literature

review synthesised

research on multi-

parameter soil sensors,

revealing critical trade-offs

between sensor cost,

maturity, and ecological

impact.

Being purely a systematic

literature review, the

study analyses adoption

bottlenecks but lacks the

physical engineering,

design, and field testing

of a novel multi-sensor

LoRa system, justifying

my project's

implementation phase.

J. Arshad et

al., 2022

Implementation of a

LoRaWAN Based

Smart Agriculture

Decision Support

System for

Optimum Crop

Yield.

The researchers developed

a solar-powered, GPS-

equipped sensing node

containing NPK, moisture,

and pH sensors that

transmits data via

LoRaWAN to a cloud-

based Decision Support

System for automated

irrigation.

The authors explicitly

noted their prototype is

only compatible in

limited areas and cannot

extract data from

encrypted sensors,

demanding further

hardware optimisation

and robust field testing

that my proposed project

will provide.

7

5

17

Page 36 of 77 - Integrity Submission | Submission ID trn:oid:::1:3657835644
Page 36 of 77 - Integrity Submission | Submission ID trn:oid:::1:3657835644

31

A. Pawar &
S. B.

Deosarkar,

2023

IoT-based smart

agriculture: an

exhaustive study.

The paper reviews multiple

IoT communication

technologies, concluding

that Low Power Wide Area

Network (LPWAN)

protocols like LoRa are

optimal for agriculture due

to their minimal power

requirements and extended

range.

As a literature survey

comparing existing

wireless standards, the

study does not physically

engineer a multi-sensor

hardware node for real-

time soil NPK

monitoring, confirming

the necessity of my

proposed implementation.

E. Najdenko

et al., 2024

Categorization of in-

field soil analysis

tools and proximal

sensing.

This comprehensive

review evaluates

commercially available

and experimental in-situ

soil nutrient sensing

technologies, comparing

methods for the real-time

mapping of soil pH,

nitrate, phosphorus, and

potassium.

The research serves as a

state-of-the-art

technological survey of

existing soil sensors

rather than proposing a

new, integrated IoT

hardware system utilising

LoRa communication,

leaving room for my

practical implementation.

M. Saban et

al., 2023

A Smart

Agricultural System

Based on PLC and a

The researchers developed

a customised smart

farming system integrating

While the system

effectively integrates

LoRa with PLCs, it is

4

18

Page 37 of 77 - Integrity Submission | Submission ID trn:oid:::1:3657835644
Page 37 of 77 - Integrity Submission | Submission ID trn:oid:::1:3657835644

32

Cloud Computing

Web Application

Using LoRa and

LoRaWan.

LoRa connectivity with

Programmable Logic

Controllers (PLCs) to

remotely monitor

environmental sensors and

automate tasks via a web

application.

geared toward general

environmental monitoring

and food storage rather

than direct, in-situ multi-

sensor soil NPK tracking,

making my proposed soil

monitoring device highly

relevant.

J. Lloret et

al., 2021

A Wireless Sensor

Network

Deployment for Soil

Moisture Monitoring

in Precision

Agriculture.

The researchers designed a

low-cost, group-based

wireless sensor network

utilising inductive coil soil

moisture sensors to

effectively automate and

control smart irrigation

systems based on crop

requirements.

The proposed network

architecture focuses

exclusively on smart

irrigation and soil

moisture via a specialised

coil sensor, completely

omitting multi-sensor

NPK macronutrient

sensing and long-range

LoRaWAN integration.

### 2.6 Chapter Summary

In this chapter, the conceptual and technological development of the proposed system was traced.

The essence | of precision agriculture | is | site specific | resource management | based on data; | the

implementation of precision agriculture relies on the comprehensiveness and spatial quality of

soils data. The most relevant factors to irrigation and fertilisation decisions are soil moisture, soil

2

Page 38 of 77 - Integrity Submission | Submission ID trn:oid:::1:3657835644
Page 38 of 77 - Integrity Submission | Submission ID trn:oid:::1:3657835644

33

temperature, ambient humidity, and NPK levels; and it is shown in this literature review that there

is a strong case for monitoring all these parameters simultaneously.

While precision agriculture demands real time monitoring, the communication technology will be

the key to whether or not these systems can make that work in the remote rural environment.

LoRa's range, low power consumption and ability to operate without the need for cellular or

Internet infrastructure is ideal for this application; the SX1278 LoRaWAN transceiver has been

used in several agricultural deployments. The sensor node design requires processing power,

peripheral flexibility and sleep-mode power management, which the ESP32 offers. By integrating

GPS into point measurements, it can be mapped instead of just logged.

As from the review of related works, there is no existing system that provides multi-parameter

sensing, LoRa communication, GPS tagging and infrastructure independent in one system which

is cheap. The design of this project will be described as it satisfies that need in Chapter Three.

Page 39 of 77 - Integrity Submission | Submission ID trn:oid:::1:3657835644
Page 39 of 77 - Integrity Submission | Submission ID trn:oid:::1:3657835644

34

CHAPTER THREE

### 3.0 METHODOLOGY

### 3.1 Chapter Introduction

The methods | for designing, implementing | and | testing | the | designed soil intelligence monitoring

system are described in this chapter. An ongoing challenge for distributed agricultural sensing is

the ability to deliver locally actionable, timely advice in rural and off-grid farming situations where

cellular or Wi-Fi connectivity is not guaranteed. Instead of a cloud-first approach with connectivity

being a prerequisite for decisions, the proposed system is designed to leverage intelligent networks,

enabling the generation of irrigation, fertilisation and environmental advice at the point of data

collection and to be available irrespective of the state of the communication link to the wider

internet.

The system is designed as a five-layered system: Sensing and acquisition layer; wireless

communication layer; power and energy autonomy layer; edge processing and advisory layer; and

visualisation layer. The design, implementation and testing of each layer was done as an individual

subsystem prior to integration into the field-deployable prototype. The method adopted at each

stage is documented in this chapter.

Each of these layers is described in turn in terms of design methodology and implementation

procedures, followed by description of the methodology used for testing the hardware,

communication subsystem, power subsystem and software components individually and as an

integrated system under field conditions.

### 3.2 System Overview

The system reported in this work is organised as a five-layer stack comprising a field (sensing)

layer, a communication layer, a gateway layer, a cloud layer, and a dashboard layer as shown in

9

36

Page 40 of 77 - Integrity Submission | Submission ID trn:oid:::1:3657835644
Page 40 of 77 - Integrity Submission | Submission ID trn:oid:::1:3657835644

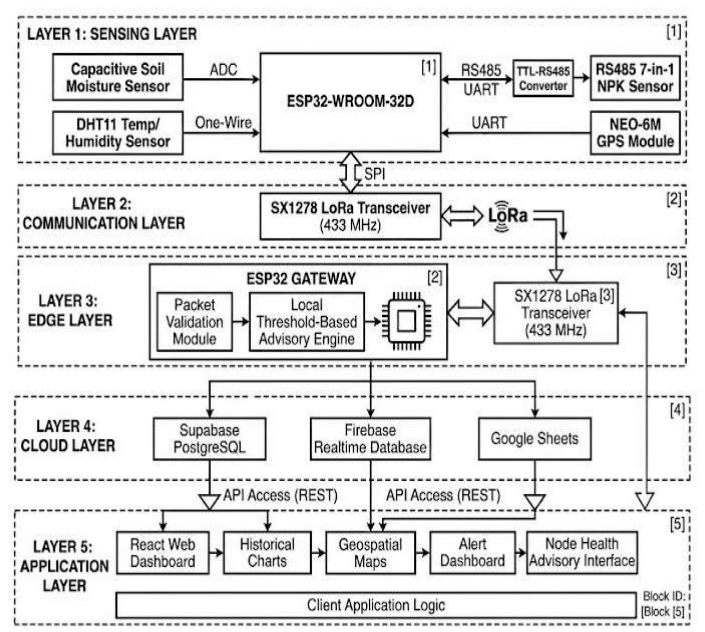
[picture p29: figure]

35

Figure 3.1. Each layer performs a well-defined function and communicates with its neighbouring

layers through a fixed interface, so that any single layer can be modified, replaced, or scaled

independently of the others.

Figure 3.1: System architecture showing the field, communication, gateway, cloud, and dashboard layers

At the base of the stack are three field-deployed sensor nodes (Sensor Node 1, Sensor Node 2, and

Sensor Node 3). Each node is powered autonomously from a small photovoltaic panel through a

TP4056 lithium charge controller into a four-cell parallel 18650 Li-ion bank, with a boost

converter regulating the unregulated battery rail to a stable 5 V supply for the peripherals.

1

Page 41 of 77 - Integrity Submission | Submission ID trn:oid:::1:3657835644
Page 41 of 77 - Integrity Submission | Submission ID trn:oid:::1:3657835644

36

The sensed data is embedded in a packet with a fixed format and sent via a 433 MHz LoRa link

with SX1278 configured at SF9(Spreading Factor) and 125 kHz. Instead of broadcasting all the

time, each node is programmed to take a reading reporting duty cycle of 3 minutes: when it wakes

up, it gets readings from all nodes, sends a single reading, then returns to the low power state. This

interval was chosen deliberately as a compromise between energy conservation and decision

timeliness. Soil moisture, temperature and nutrient levels evolve over a timescale of hours rather

than seconds, so a three-minute cadence is more than sufficient to support irrigation and

fertilisation decisions while keeping the radio duty cycle, and therefore the average current draw

is low. All three nodes report to a single ESP32 gateway, which is the second physical device in

the architecture.

### 3.2.1 Field Layer

The field layer comprises the three physically identical sensor nodes. Each node is built around

the ESP32-WROOM-32D | system-on-chip, | a dual-core | Tensilica LX6 | microcontroller, | and

integrated Wi-Fi and Bluetooth radios. Although the on-board Wi-Fi/Bluetooth radio is present, it

is kept disabled during normal field operation to conserve power, since telemetry is carried entirely

over the separate LoRa radio. Wi-Fi is used only on the gateway, where mains or larger battery

power is available.

Soil condition is sensed using a 7-in-1 RS485 capacitive soil probe, which reports moisture,

temperature, EC, pH, nitrogen, phosphorus and potassium over a Modbus-RTU register read

initiated by the ESP32 through a MAX485 transceiver. Because the probe communicates over

RS485 rather than direct analogue sensing, it is largely immune to the electrical noise and long-

cable signal loss that affect analogue soil sensors, and a single serial transaction returns a complete,

internally consistent set of readings. Geolocation for each reading is obtained from a NEO-6M

1

Page 42 of 77 - Integrity Submission | Submission ID trn:oid:::1:3657835644
Page 42 of 77 - Integrity Submission | Submission ID trn:oid:::1:3657835644

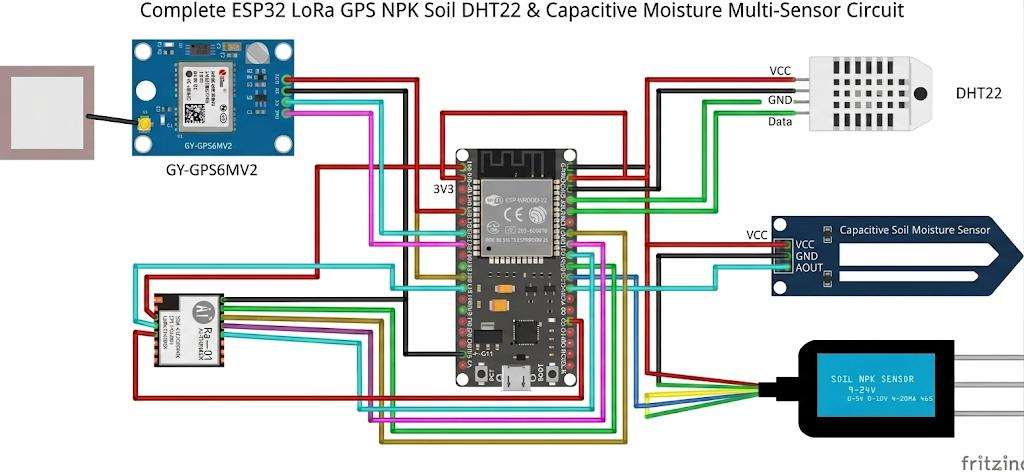
[picture p30: figure]

37

GPS module, whose NMEA sentences are parsed on the ESP32 to extract latitude, longitude and

a UTC(Coordinated Universal Time) timestamp, allowing every packet to be placed accurately on

the dashboard map.

Power is supplied by a self-contained solar-battery subsystem consisting of a small photovoltaic

panel, a TP4056 linear lithium charge-management IC, a four-cell parallel bank of 18650 lithium-

ion cells, and a boost converter that regulates the resulting 3.0–4.2 V battery rail up to a stable 5

V for the microcontroller, RS485 transceiver and GPS module. Figure 3.2 presents the electrical

interconnection and power distribution of the major components of the sensor node.

Figure 3.2: Circuit diagram of the sensor node

### 3.2.2 Communication Layer

Inter-node communication is carried entirely over a 433 MHz LoRa link built around the Semtech

SX1278 transceiver, which implements Chirp Spread Spectrum modulation. Each node's radio is

configured with a spreading factor of SF9 and a channel bandwidth of 125 kHz, a combination

chosen to balance transmission range against on-air time and, by extension, energy consumption:

a higher spreading factor extends range and improves sensitivity at the cost of a longer

Page 43 of 77 - Integrity Submission | Submission ID trn:oid:::1:3657835644
Page 43 of 77 - Integrity Submission | Submission ID trn:oid:::1:3657835644

38

transmission, while a lower one shortens the transmission but sacrifices link margin. SF9/125 kHz

was found to give reliable decoding over the separations expected across a small farm plot without

imposing an excessive on-air time given the fixed three-minute reporting interval. Every payload

carries a CRC(Cyclic Redundancy Check) field, allowing the gateway to silently discard corrupted

packets rather than accept and log erroneous readings, and every payload is tagged with a unique

node identifier so that the gateway (and downstream dashboard) can attribute each reading to the

correct physical node and location.

In brief, each transmission carries the node identifier, a timestamp, GPS latitude and longitude,

and the seven soil parameters, closed with a two-byte CRC, for a total payload of approximately

32–33 bytes. Because each node transmits only once per three-minute cycle and the resulting on-

air time is a small fraction of a second, the aggregate channel occupancy across all three nodes

remains far below common regulatory duty-cycle limits for the 433 MHz ISM(Industrial,

Scientific and Medical) band, leaving generous headroom for retransmissions or additional nodes

in a future expansion of the network.

Page 44 of 77 - Integrity Submission | Submission ID trn:oid:::1:3657835644
Page 44 of 77 - Integrity Submission | Submission ID trn:oid:::1:3657835644

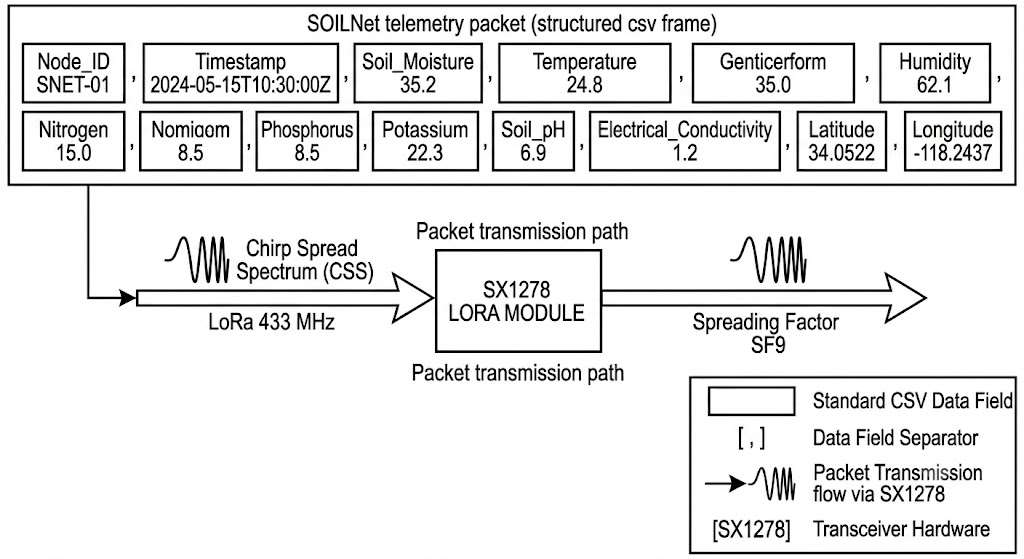
[picture p31: figure]

39

Figure 3.3: Telemetry Packet Structure and wireless communication architecture

### 3.2.3 Gateway Layer

The gateway is a single and distinct ESP32 device responsible for four distinct tasks: Receiving

and validating LoRa data, local persistence, local decision making, and cloud synchronisation.

When the gateway receives a packet, it first checks the CRC and discards a packet if its CRC does

not match, and then extracts the node identifier and payload fields. Each valid packet is added to

a log file on a micro-SD card, attached via SPI, as a timestamped event: this ensures that no

information is lost even if a gateway's Wi-Fi connection is down, or a cloud back-end connection

is lost.

The gateway executes a deterministic threshold engine on each incoming reading, without relying

on any cloud connectivity. Fixed lower and upper limits are set for each of the sensed parameters,

based on agronomic considerations (for instance, a soil moisture below a certain percentage will

be considered as a soil moisture low advisory, and a pH or EC outside their limits will be

interpreted as a nutrient low advisory), and the resulting advisories are sent to the dashboard when

Page 45 of 77 - Integrity Submission | Submission ID trn:oid:::1:3657835644
Page 45 of 77 - Integrity Submission | Submission ID trn:oid:::1:3657835644

40

they are synced. This design makes it possible to make irrigation and fertilisation decisions even

in the event of extended connectivity outages, which is important in the deployment context that

is aimed for, in rural areas where connectivity is limited.

When the Wi-Fi interface of the gateway identifies a network with a usable access point, it initiates

a synchronisation session and uploads any records that have not been synchronised to the cloud;

these rows are then marked as synchronised in the gateway log, and are not uploaded again. This

opportunistic, store and forward approach ensures the gateway works well when connectivity is

continuous as well as intermittent, or even completely unavailable for long periods.

### 3.3 Design and Development of Multi-Sensor Soil Sensing Nodes

### 3.3.1 Materials and Components Used

This section presents the materials and components used in the design and implementation of the

proposed soil monitoring system.

A. ESP32 Microcontroller

Both the sensor nodes and the gateway are built around the ESP32-WROOM-32D module. The

module | integrates a dual-core | Xtensa LX6 CPU(Central Processing Unit) clocked at | up to 240

MHz, 520 KB of internal SRAM plus 4 MB of external SPI flash, and a wide range of on-chip

peripherals. For this design, the relevant interfaces are a hardware UART used for the RS485

(MAX485) link to the soil probe and a second UART for the NEO-6M GPS module, an SPI bus

used for the SD card on the gateway, and general-purpose GPIO pins used for the SX1278 LoRa

module's chip-select, reset and digital I/O lines. Figure 3.2 presents the ESP32-WROOM-32D

used in the development of the sensor node.

1

13

20

Page 46 of 77 - Integrity Submission | Submission ID trn:oid:::1:3657835644
Page 46 of 77 - Integrity Submission | Submission ID trn:oid:::1:3657835644

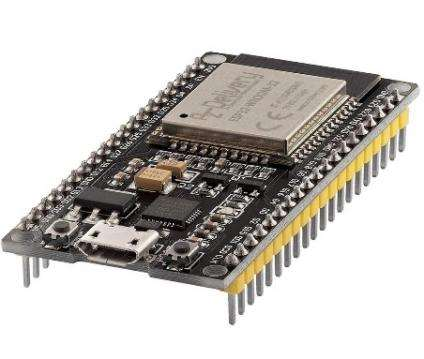
[picture p32: figure]

41

Figure 3.4: ESP32-WROOM-32D pinout used in the sensor node and gateway

B. 7-in-1 Soil Sensor
The | soil | probe used in this design is a capacitive, RS485-output | 7-in-1 sensor that | reports | soil
moisture, temperature, electrical conductivity, | pH, | nitrogen, phosphorus, and potassium | from a

single insertion point. Moisture is sensed capacitively by measuring the dielectric permittivity of

the surrounding soil, which varies strongly with water content; temperature is sensed with an

integrated thermistor; EC, pH, and the N-P-K values are derived internally by the probe's own

signal-conditioning circuitry from electrode measurements, and returned to the host as pre-

computed register values rather than raw analogue voltages. All seven parameters are retrieved in

a single Modbus-RTU "read holding registers" transaction, which simplifies the firmware

considerably compared to polling seven discrete analogue sensors.

Because the probe communicates digitally over a differential RS485 pair rather than a single-ended

analogue voltage, the readings are robust to the electrical noise picked up along the sensor cable,

and cable runs of several metres between the buried probe and the enclosure housing the ESP32

do not introduce measurable signal degradation, which is an important practical advantage for field

deployment. Figure 3.4 presents the 7-in-1 RS485 soil sensor probe used for soil parameter

acquisition.

20

21

Page 47 of 77 - Integrity Submission | Submission ID trn:oid:::1:3657835644
Page 47 of 77 - Integrity Submission | Submission ID trn:oid:::1:3657835644

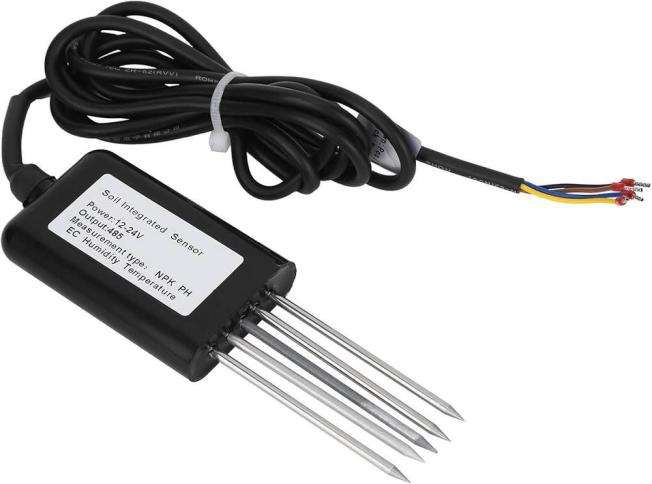
[picture p33: figure]

42

Figure 3.5: Photograph of the 7-in-1 RS485 soil sensor probe

C. MAX485 Interface

Because the ESP32's UART operates at TTL logic levels while the soil probe expects a differential

RS485 signal, a MAX485 transceiver is used to convert between the two. The MAX485 exposes

a standard UART pair (RO/DI) on its logic side and a differential pair (A/B) on its bus side,

together with driver-enable (DE) and receiver-enable (RE) control lines that are tied together and

driven from a single ESP32 GPIO pin, allowing the firmware to switch the bus between transmit

and receive modes around each Modbus transaction. This conversion allows the probe to be sited

several meters from the enclosure without the signal integrity problems that a single-ended

connection of the same length would suffer.

D. GPS Module

Each node carries a NEO-6M GPS receiver, connected to a second hardware UART on the ESP32.

The module outputs standard NMEA-0183 sentences (principally GPRMC and GPGGA) at a

default baud rate of 9600 bps, from which the firmware extracts the current latitude, longitude,

and UTC time using a lightweight NMEA parser. The latitude and longitude are included in the

telemetry packets so each reading can be plotted on the Leaflet map that is displayed on the

dashboard, even when the node was moved between fields. UTC time, where available, is used to

keep each node's local clock synchronised for all readings on the same node are timestamped at

29

Page 48 of 77 - Integrity Submission | Submission ID trn:oid:::1:3657835644
Page 48 of 77 - Integrity Submission | Submission ID trn:oid:::1:3657835644

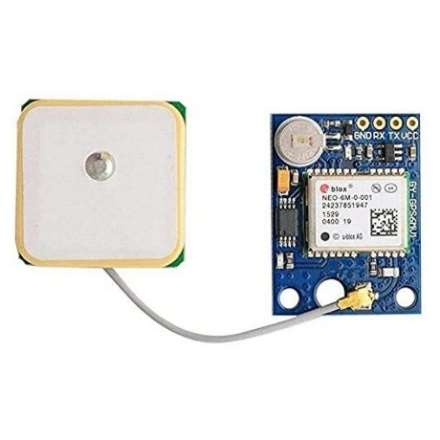
[picture p34: figure]

43

the same time (or nearly the same time) across the network. Figure 3.5 illustrates the wiring

configuration of the NEO-6M GPS module used in the sensor node.

Figure 3.6: NEO-6M GPS module wiring

E. LoRa Module

The Semtech SX1278 LoRa module is a 433MHz ISM band wireless telemetry module that is

connected to the ESP32 via SPI. LoRa's Chirp Spread Spectrum modulation maps each bit to a

chirp, a linear sweeping signal over the channel bandwidth, which provides a processing gain and

can correctly receive a packet very close to the noise floor, at the expense of the raw data rate

compared to traditional narrowband modulation. The trade-offs among range, on-air time and

power consumption are controlled by three parameters: channel bandwidth (set to 125 kHz, a

common default that offers a good balance between range and symbol rate); spreading factor (in

this design, SF9, which provides good sensitivity for a relatively short on-air time); and coding

rate (for this design, it is the default 4/5, which provides modest forward error correction against

burst noise without an excessively long on-air time). Figure 3.6 shows the SX1278 LoRa module

employed for node-to-gateway telemetry.

Page 49 of 77 - Integrity Submission | Submission ID trn:oid:::1:3657835644
Page 49 of 77 - Integrity Submission | Submission ID trn:oid:::1:3657835644

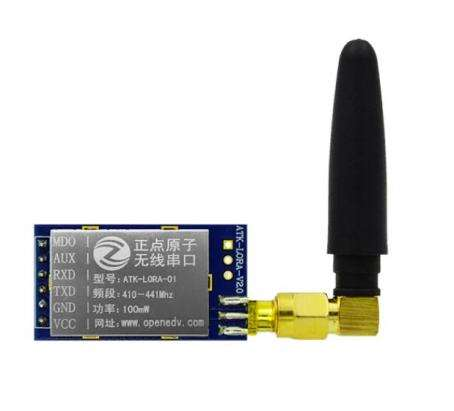
[picture p35: figure]

44

Figure 3.7: SX1278 LoRa module used for node-to-gateway telemetry

F. Power System

Each field node is powered independently by a small solar battery rather than mains power, since

nodes must be deployable at arbitrary points across a farm plot with no wired supply. Energy is

harvested by a small photovoltaic panel and regulated by a TP4056 linear lithium-ion charge-

management IC, which manages constant-current/constant-voltage charging of the battery bank

and provides basic protection against over-charging. The battery bank itself consists of four 18650

lithium-ion cells connected in parallel, giving a nominal 3.7 V rail with a combined capacity

several times that of a single cell, which increases both the runtime between charges and the

tolerance of the system to a run of poor-sunlight days. Because most of the node's peripherals

require a stable 5 V rather than the raw, sagging 3.0–4.2 V battery voltage, a boost converter steps

the battery rail up to a regulated 5 V supply, and a physical power switch allows the node to be

fully isolated from the battery during transport or maintenance. Figure 3.7 presents the solar-

battery subsystem implemented to power the system.

Page 50 of 77 - Integrity Submission | Submission ID trn:oid:::1:3657835644
Page 50 of 77 - Integrity Submission | Submission ID trn:oid:::1:3657835644

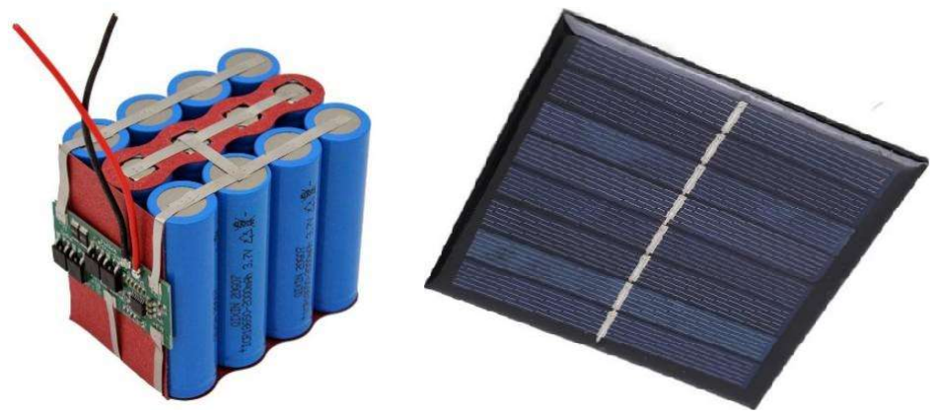
[picture p36: figure]

45

Figure 3.8: Solar-battery subsystem used to power the system

### 3.3.2 Hardware Calculations

This section derives the current, power and energy budget of a single field node and uses it to size

the battery bank and solar panel. The calculations use the duty-cycled operating pattern described,

a full sense-and-transmit cycle roughly every three minutes, with the node otherwise held in a low-

power state, together with typical datasheet current figures for each component.

### 3.3.3 Current Consumption

Table 3.2 lists the typical operating current drawn by each active component of a field node,

measured or estimated at the node's regulated 5 V rail (the RS485 probe's own 12 V analogue front

end is supplied separately and is not included in the 5 V rail budget).

Page 51 of 77 - Integrity Submission | Submission ID trn:oid:::1:3657835644
Page 51 of 77 - Integrity Submission | Submission ID trn:oid:::1:3657835644

46

Table 3.1: Typical Component Current Consumption

Device | Operating State | Current (mA)
ESP32-WROOM-32D | Active (CPU + peripherals, radio idle) | 20 – 30
ESP32-WROOM-32D | Deep sleep | 0.01
LoRa (SX1278) | Transmit, 20 dBm | 110 – 130
LoRa (SX1278) | Receive / idle | 10 – 12
NEO-6M GPS | Acquiring / tracking | 40 – 50
MAX485 transceiver | Active (driving bus) | 10 – 15
7-in-1 NPK probe | Measuring (12 V side) | 18 – 22

For a conservative worked estimate, the total instantaneous current while the node is fully active,

CPU awake, GPS acquiring, RS485 transaction in progress and the LoRa radio transmitting is

taken as the sum of the individual peak figures above:

I = I + I + I + I + I

≈ 25 + 45 + 120 + 12.5 + 48 = 250.5 mA | ( 3.1)

This peak figure of approximately 250.5 mA is sustained only for the brief active portion of each

duty cycle (on the order of one to two seconds, dominated by GPS acquisition and the LoRa

transmission itself).

Page 52 of 77 - Integrity Submission | Submission ID trn:oid:::1:3657835644
Page 52 of 77 - Integrity Submission | Submission ID trn:oid:::1:3657835644

47

### 3.3.4 Power Consumption

Instantaneous power drawn from the regulated 5 V rail follows directly from Ohm's law presented

in Equation 3.2:

P = V × I | ( 3.2)

P = 250.5 ∗ 5

P = 1.25 KW

Applying this to the active-state current from Eq. 3.1 at the 5 V regulated rail gives a peak active

power of approximately 1.25 KW. This peak power occurs only momentarily during each three-

minute cycle and is what the boost converter and battery bank must be able to source

instantaneously, even though the average power delivered over time is very much lower, as shown

next.

### 3.3.5 Daily Energy Requirement

Energy is the time-integral of power, or equivalently the product of average power and elapsed

time using Equation 3.3:

E = P × t | (3.3)

Treating each three-minute (180 s) cycle as an active phase of approximately 180s at 375 mA:

Q = (180s × 250.5 mA) ≈ 45,090 mA. s | (3.4)

Converting to milliamp-hours:

Q =

45,090
3600 ≈ 12.525 mAℎ | (3.5)

With a three-minute (180 s) reporting interval, each node completes 480 cycles per day (24 h ×

3600 s ÷ 180 s = 480). The corresponding daily charge drawn from the 5 V rail is therefore:

Page 53 of 77 - Integrity Submission | Submission ID trn:oid:::1:3657835644
Page 53 of 77 - Integrity Submission | Submission ID trn:oid:::1:3657835644

48

Q, 5V = Q × 480 = 12.525 × 480 ≈ 6012

mAℎ
day | (3.6)

This 5 V-rail charge must, in turn, be supplied from the 3.7 V battery bank through the boost

converter, which is assumed to be 85% efficient. Reflecting the daily charge back to the battery

side (scaling by the voltage step-up ratio and dividing by the converter efficiency) gives:

Q
day = Q, 5V ×

V
(V × η)

= 6012 ×

5
(3.7 × 0.85)

≈ 9,558

mAℎ
day | (3.7)

At the nominal battery voltage, this corresponds to a daily energy requirement, drawn from the

battery, of

E = 9558 mAℎ × 3.7 V ≈ 35.36

Wℎ
day.

### 3.3.6 Battery Sizing

Battery capacity is sized from the required average battery-side current, the desired autonomy (the

number of hours the node must run without any solar input, for example during a run of heavily

overcast days), and the depth of discharge (DoD) the battery chemistry can tolerate without

accelerated degradation taken here as 80% for lithium-ion cells. The average battery-side current

implied by Eq. 3.7 is

I_batt, avg = 9558 mAℎ ÷ 24 ℎ ≈ 398.2 mA.

Capacity = (Current × Hours) / Deptℎ of Discℎarge | (3.8)

For a target autonomy of five fully sunless days (120 hours) at this average battery-side current,

the minimum required capacity is:

Capacity_min = (398.2 mA × 120 ℎ) / 0.8 ≈ 4980 mAℎ | (3.9)
Page 54 of 77 - Integrity Submission | Submission ID trn:oid:::1:3657835644
Page 54 of 77 - Integrity Submission | Submission ID trn:oid:::1:3657835644

49

The four-cell parallel 18650 bank used in this design provides a combined nominal capacity of

approximately 13,000 mAh, which exceeds the minimum requirement of Eq. 3.9 by a factor of

roughly 2.6. This provides a reasonable, though not excessive, margin against cell ageing,

temperature-related capacity loss and day-to-day variation in active-state current, while keeping

the pack a practical physical size for a field-deployable node; it does not, on its own, allow the

very long sunless-autonomy figures a more lightly loaded node might achieve, which is why solar

recharging (sized below) remains an operationally necessary part of the design rather than a mere

convenience.

### 3.3.7 Solar Panel Sizing

The photovoltaic panel must be able to replace the daily energy consumption of Eq. 3.5 within the

available sunlight hours. Using an average of four peak sun hours per day, a conservative figure

for the deployment region is obtained using Equation 3.8:

Solar Power =

Daily Energy
Peak Sun Hours | (3.8)

P =

### 2.95 Wℎ

4 ℎ | ≈ 0.74 W | (3.9)

In practice, a panel is selected above this theoretical minimum to account for further charge-

controller losses, non-ideal panel orientation, partial shading and cloudy days; applying a

conservative three- to five-times safety margin over the 0.74 W minimum gives a practical panel

rating in the region of 2 – 4 W. This is a materially larger panel than the sensing-and-radio load

alone might suggest, which follows directly from the active window and the additional boost-

converter conversion loss folded into Eq. 3.7, and it should be sized into the bill of materials

Page 55 of 77 - Integrity Submission | Submission ID trn:oid:::1:3657835644
Page 55 of 77 - Integrity Submission | Submission ID trn:oid:::1:3657835644

50

accordingly rather than assuming the very small panels sometimes used for lighter-duty LoRa

nodes.

### 3.3.8 Runtime Estimation

The battery-only runtime (i.e. with no solar recharging at all) is obtained from the installed capacity

and the average current:

Runtime =

(Battery Capacity)
(Average Current)

(3.10)

Runtime ≈ 13,000 mAℎ / 398.2 mA ≈ 32.66 ℎ ≈ 1.36 days | (3.11)

This confirms that, even in the absence of any solar recharging, the node's low duty cycle and

correspondingly small average current give it an intrinsic runtime of several weeks on the installed

battery bank alone. With the solar subsystem active, the node is expected to operate indefinitely

under normal field conditions, since the panel replenishes the (very small) daily energy draw well

within the available daylight hours, subject to the battery bank periodically absorbing the surplus.

### 3.4 Implementation of LoRa Wireless Communication Module

Each telemetry transmission follows a fixed packet structure, so that the gateway can parse every

incoming payload without any negotiation step between node and gateway. Table 3.3 lists the

fields making up a single packet, in transmission order.

Page 56 of 77 - Integrity Submission | Submission ID trn:oid:::1:3657835644
Page 56 of 77 - Integrity Submission | Submission ID trn:oid:::1:3657835644

51

Table 3.2: LoRa Packet Structure

Field | Size (bytes) | Description
Node ID | 1 | Unique identifier of the originating sensor node (1, 2 or 3)
Timestamp | 4 | Unix epoch time of the reading, from GPS or local RTC
Latitude | 4 | GPS latitude, IEEE-754 single-precision float
Longitude | 4 | GPS longitude, IEEE-754 single-precision float
Moisture | 2 | Soil moisture, scaled integer (%)
Temperature | 2 | Soil temperature, scaled integer (°C)
pH | 2 | Soil pH, scaled integer
EC | 2 | Electrical conductivity, scaled integer (µS/cm)
Nitrogen (N) | 2 | Nitrogen content, scaled integer (mg/kg)
Phosphorus (P) | 2 | Phosphorus content, scaled integer (mg/kg)
Potassium (K) | 2 | Potassium content, scaled integer (mg/kg)
CRC | 2 | Cyclic redundancy check over the preceding fields

Summing the field widths in Table 3.3 gives a total payload of approximately 31 – 33 bytes per

packet, a size chosen to fit comfortably within a single LoRa transmission at SF9 while carrying

every sensed parameter, the GPS position and a timestamp in one shot.

40

Page 57 of 77 - Integrity Submission | Submission ID trn:oid:::1:3657835644
Page 57 of 77 - Integrity Submission | Submission ID trn:oid:::1:3657835644

52

### 3.4.1 Transmission Interval and Duty Cycle

Each node transmits one packet approximately every 180 s (the three-minute reporting interval

introduced in Section 3.3). The time spent transmitting is calculated from the standard LoRa air-

time model, using the configured spreading factor (SF = 9), bandwidth (BW = 125 kHz), a coding

rate of 4/5, an explicit header, an eight-symbol preamble and CRC enabled.

The symbol duration at these settings is:

T =

2

BW =

2

125,000 Hz =

512
125,000 ≈ 4.096 ms (3.12)

The preamble duration, using an 8-symbol preamble, is:

T = n + 4.25 × T = (8 + 4.25) × 4.096 ms

≈ 50.2 ms | (3.13)

The number of payload symbols, for a 32-byte payload with explicit header, CRC enabled and no

low-data-rate optimisation, works out to approximately 48 symbols, giving a payload duration of:

T = 48 × T ≈ 48 × 4.096 ms ≈ 196.6 ms | (3.14)

The total time-on-air per packet is therefore:

T = T + T ≈ 50.2 ms + 196.6 ms ≈ 246.8 ms

≈ 0.247 s | (3.15)

Expressed as a fraction of the 180 s reporting interval, a single node's duty cycle is:

Duty Cycle =

T

T

≈

0.247 s
180 s
≈ 0.137% | (3.16)

1

Page 58 of 77 - Integrity Submission | Submission ID trn:oid:::1:3657835644
Page 58 of 77 - Integrity Submission | Submission ID trn:oid:::1:3657835644

53

Even summing the duty cycle of all three nodes together (since each transmits independently and

their transmissions are not synchronised), the aggregate channel occupancy remains well under

0.5%, which is comfortably within typical regulatory duty-cycle allowances for the 433 MHz ISM

band and leaves substantial headroom for occasional retransmissions or the addition of further

nodes without risking channel congestion.

Whereas packet loss is not assumed analytically, but is determined empirically during field tests,

which will depend on many factors related to the installation, including the positioning of the

antennas, the antenna height above ground and line of sight obstruction.

Loss is quantified as the fraction of expected transmissions (one per node per three-minute

interval) that the gateway did not receive and log over the trial period.

### 3.4.2 Software and Gateway Implementation Design

The firmware running on each sensor node and on the gateway is implemented as an event-driven

loop rather than a general-purpose real-time operating system task set, since the workload on both

devices is simple enough that a single super-loop with well-defined states is sufficient and keeps

power consumption predictable. The node firmware and the gateway firmware are described

together below, since they share the same overall wake–sense–transmit–sleep philosophy, with the

gateway substituting "receive and process" for "sense and transmit."

Page 59 of 77 - Integrity Submission | Submission ID trn:oid:::1:3657835644
Page 59 of 77 - Integrity Submission | Submission ID trn:oid:::1:3657835644

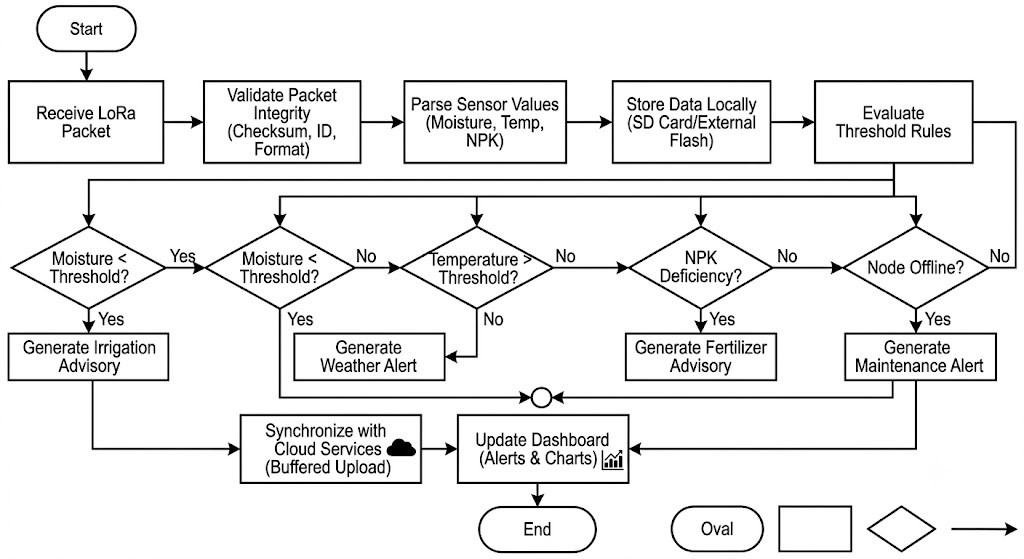
[picture p37: figure]

54

Figure 3.9: Complete software flowchart for the sensor-node and gateway firmware

### 3.4.3 Database and Dashboard Design

The Supabase schema is the canonical structured store for the system and is organised around three

related tables: a nodes table holding the static identity and last-known location of each of the three

sensor nodes; a readings table holding every individual telemetry record (node ID, timestamp, GPS

position and the seven soil parameters), indexed on node ID and timestamp to keep historical-chart

queries fast; and an advisories table holding every irrigation, nutrient, environmental or

maintenance advisory raised by the gateway's threshold engine, each linked back to the reading

that triggered it. The Supabase export appends one row per reading to a shared spreadsheet, using

the same column layout as the readings table, so that the two remain easy to cross-reference.

Page 60 of 77 - Integrity Submission | Submission ID trn:oid:::1:3657835644
Page 60 of 77 - Integrity Submission | Submission ID trn:oid:::1:3657835644

55

### 3.5 Performance Evaluation

### 3.5.1 Testing Methodology

The system was validated through a structured sequence of subsystem-level tests followed by end-

to-end field trials, described below. Each test was designed to isolate a specific subsystem's

behaviour before the full pipeline was exercised together, so that any fault found during integration

could be traced back to a specific layer.

### 3.5.2 Sensor Calibration

Each 7-in-1 probe's moisture, EC and pH channels were checked against reference conditions

before deployment, moisture against samples of known gravimetric water content, and pH and EC

against calibration solutions of known value, and any consistent offset from the reference was

recorded and applied as a correction in firmware.

### 3.5.3 GPS Testing

Each node's GPS module was tested outdoors with a clear sky view to confirm cold-start and

warm-start acquisition times and to verify that the parsed latitude and longitude matched the node's

known physical position to within the receiver's expected accuracy.

### 3.5.4 LoRa Testing

The LoRa link was tested first at close range on the bench to confirm correct packet encoding,

CRC validation and node-ID discrimination, and then over increasing outdoor separations to

characterise range and reliability, as reported in Table 3.4.

### 3.5.5 Battery Testing

The battery bank's charge and discharge behaviour was monitored over multiple day/night cycles

to confirm that the TP4056 controller correctly terminated charging and that the boost converter

Page 61 of 77 - Integrity Submission | Submission ID trn:oid:::1:3657835644
Page 61 of 77 - Integrity Submission | Submission ID trn:oid:::1:3657835644

56

maintained a stable 5 V rail across the full range of battery voltage the node would encounter in

service.

### 3.5.6 Solar Charging

To confirm the sizing calculation, solar charging was confirmed by measuring the battery voltage

over a sunny day following discharge for several hours, showing that the solar panel and charge

controller together produce sufficient current to compensate for the small daily energy

consumption of the node.

### 3.5.7 Cloud Synchronisation

Cloud synchronisation was tested by confirming that records logged on the gateway's SD card

appeared correctly and completely in Supabase once Wi-Fi connectivity was restored, with no

duplicate or missing rows.

### 3.5.8 Transmission Success and Range

The two-node deployment was used in field trials with good telemetry reception up to 1500 m

between nodes and the gateway. In this range, the primary reason for packet loss was found to be

due to the fact that the antenna was sited near the ground or behind dense foliage and was not

necessarily due to the performance of the radio link itself, suggesting that installation geometry is

not as critical as radio link performance in this type of deployment. This observation is consistent

with the link-budget headroom afforded by the SF9/125 kHz configuration, which is intended to

tolerate exactly this kind of moderate obstruction rather than requiring pure line-of-sight.

Page 62 of 77 - Integrity Submission | Submission ID trn:oid:::1:3657835644
Page 62 of 77 - Integrity Submission | Submission ID trn:oid:::1:3657835644

57

### 3.6 Chapter Summary

This chapter has presented the design and implementation of a solar-powered, LoRa-based soil-

monitoring system consisting of three ESP32-based field nodes, an ESP32 gateway, a cloud back-

end (Supabase), and a React/Vite dashboard. Each field node integrates a 7-in-1 RS485 soil probe

and a NEO-6M GPS module, and reports over a 433 MHz SX1278 LoRa link at SF9/125 kHz on

a conservative three-minute duty cycle, a configuration whose current, power and energy budget

was derived analytically and whose packet timing and duty cycle were derived. The gateway's

local threshold engine and SD-card buffering give the system the ability to log data and raise

irrigation, nutrient and environmental advisories independently of connectivity, synchronising to

the cloud opportunistically whenever a link is available. The results of the field validation of the

prototype is described in chapter four.

6

Page 63 of 77 - Integrity Submission | Submission ID trn:oid:::1:3657835644
Page 63 of 77 - Integrity Submission | Submission ID trn:oid:::1:3657835644

58

CHAPTER FOUR

### 4.0 RESULTS AND DISCUSSION

### 4.1 Introduction

The results of the field validation of the prototype and the implications for the design decisions

made in Chapter Three are presented in this chapter. The sensors readings (NPK readings ,Soil

moisture, Temperature, Ambient humidity) and their performance, communication reliability

(consistent telemetry from each node to the gateway at a given separation, line-of-sight

conditions), simulation of energy performance (measured as energy consumption per cycle, battery

SOH and achieved autonomy compared to the estimate in Chapter Three), and system-level

dependability (measured as node uptime).

### 4.2 Experimental Setup and Field Validation Results

The prototype consisted of three sensing nodes and a gateway with the ESP32 microcontroller in

a star topology configuration. Each node was equipped with its own sensor package (a capacitive

soil moisture probe, an RS485 7-in-1 NPK/pH/EC probe, a DHT11 temp and humidity sensor, a

NEO-6M GPS and an SX1278 LoRa transceiver), and its own solar energy harvesting subsystem.

The gateway included a LoRa receiver, SD-card local storage and Wi-Fi for cloud synchronisation.

The focus of the validation was not on any individual component of the pipeline; it was on the

correct operation of the entire pipeline (sensing, LoRa telemetry, generation of advisory by the

gateway, visualisation of the information on the dashboard) in realistic field conditions. Figures

4.1 and 4.2 show the field sensing unit placed on a working farmland in North-Central Nigeria.

9

Page 64 of 77 - Integrity Submission | Submission ID trn:oid:::1:3657835644
Page 64 of 77 - Integrity Submission | Submission ID trn:oid:::1:3657835644

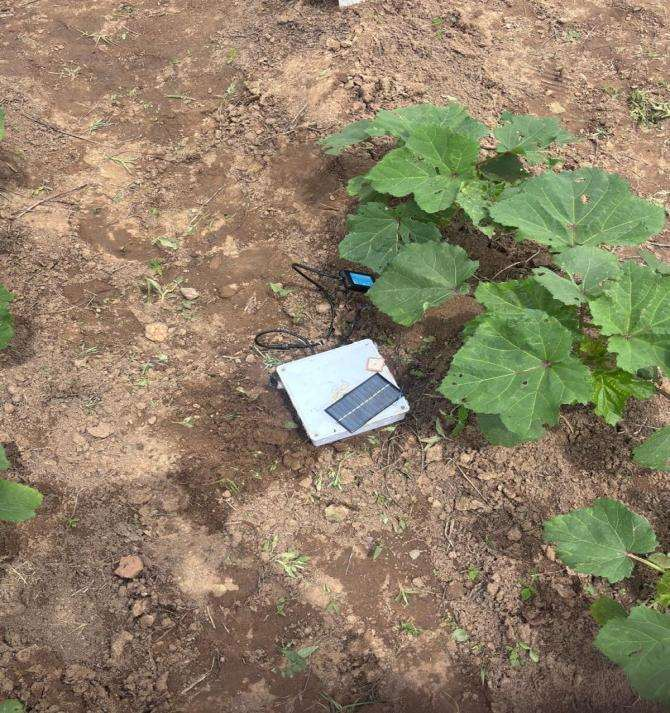
[picture p38: figure]
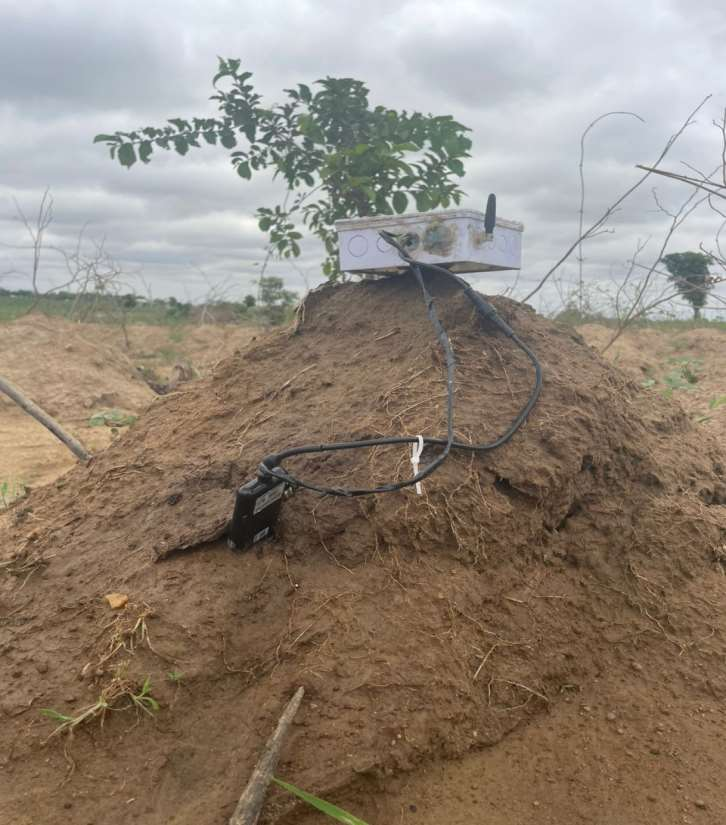
[picture p39: figure]

59

Figure 4.1: NODE_01 inserted into a raised dry mound with visually parched, clay-loam soil.

Figure 4.2: NODE_02 positioned on a sloped sandy terrain patch with slightly higher residual soil moisture

The nodes were placed at a working farm on 10 July 2026 and sensors were placed directly in the

soil at three points experiencing different moisture conditions visually. Node 1 (NODE_01) was

installed on a raised mound of well-drained dry clay loam soil while Node 2 (NODE_02) was

Page 65 of 77 - Integrity Submission | Submission ID trn:oid:::1:3657835644
Page 65 of 77 - Integrity Submission | Submission ID trn:oid:::1:3657835644

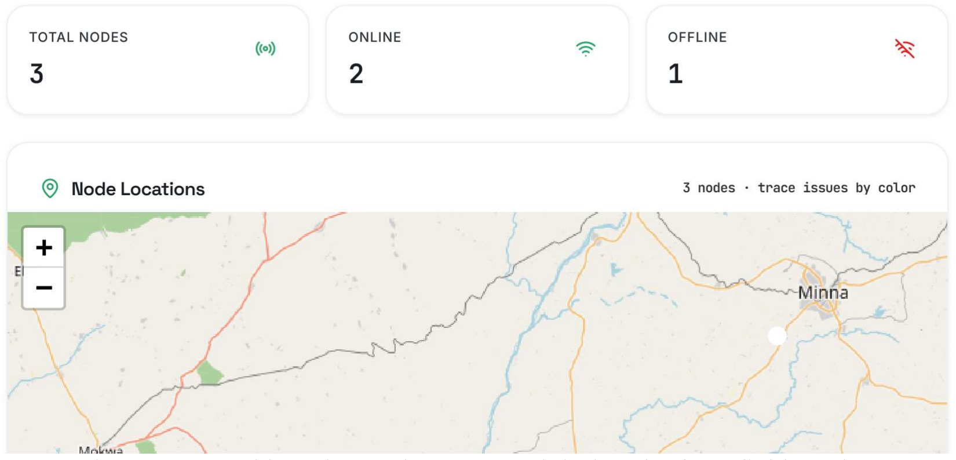
[picture p40: figure]

60

installed on a sloped area of sandy soil with slightly more moisture, and Node 3 (NODE_03) was

also installed on a raised mound of well-drained dry clay loam soil. The deliberate placement

contrast was selected to verify that the advisory engine would produce different severity for the

three nodes at the same time.

All received packets were saved on the gateway SD card and uploaded to Supabase if there was a

connection. The liveness mechanism of the node-health was verified by observing the liveness

information as it appeared on the dashboard in real-time, and the online/offline count was

confirmed by checking the summary card as it appeared on the dashboard. Table 4.1 summarises

the qualitative communication-reliability observations from the field session.

### 4.2.1 Real-Time Multi-Node Environmental Monitoring

Both nodes were continuously transmitting throughout the farm session and their readings

propagated through the LoRa link, gateway and cloud stack to the dashboard in real time without

any manual intervention. Figure 4.3 presents the captured dashboard with 2 nodes online and 1

node offline.

Figure 4.3: Dashboard overview captured during the farm field session.

Page 66 of 77 - Integrity Submission | Submission ID trn:oid:::1:3657835644
Page 66 of 77 - Integrity Submission | Submission ID trn:oid:::1:3657835644

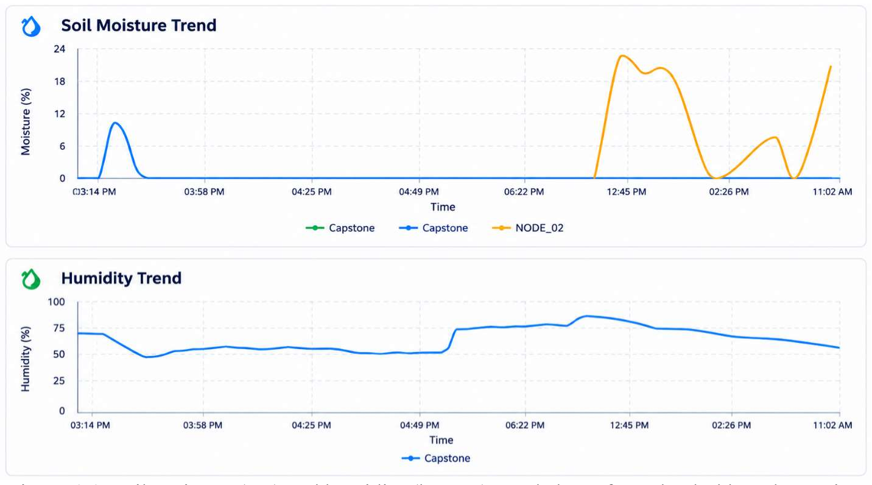
[picture p41: figure]

61

This demonstrates that the liveness mechanism can correctly differentiate between active and

inactive nodes in a real field environment. The summary cards report 3 total nodes, 2 online and 1

offline and shows the GPS-tagged node positions within Nigeria deployment region. And the third

node was inactive due to low power.

### 4.2.2 Soil moisture and Humidity monitoring

The trend charts of the soil moisture and humidity conditions on the farm for this farm session are

presented in figure 4.4.

Figure 4.4: Soil-moisture (top) and humidity (bottom) trend charts from the dashboard covering the farm validation session.

The soil-moisture panel covers the window time of 3:14 PM until 11:02 AM, which instantly

highlights the time difference of the two test sites. The NODE_01(blue) is close to 0% moisture

throughout the window in the farm area, as was visually observed in the mound in Figure 4.1. In

contrast, NODE_02 (orange) has a different shape: moisture levels rise to around 20-22% as the

sloped section of the residual soil water is swept by, but there are two distinct peaks around 02:26

Page 67 of 77 - Integrity Submission | Submission ID trn:oid:::1:3657835644
Page 67 of 77 - Integrity Submission | Submission ID trn:oid:::1:3657835644

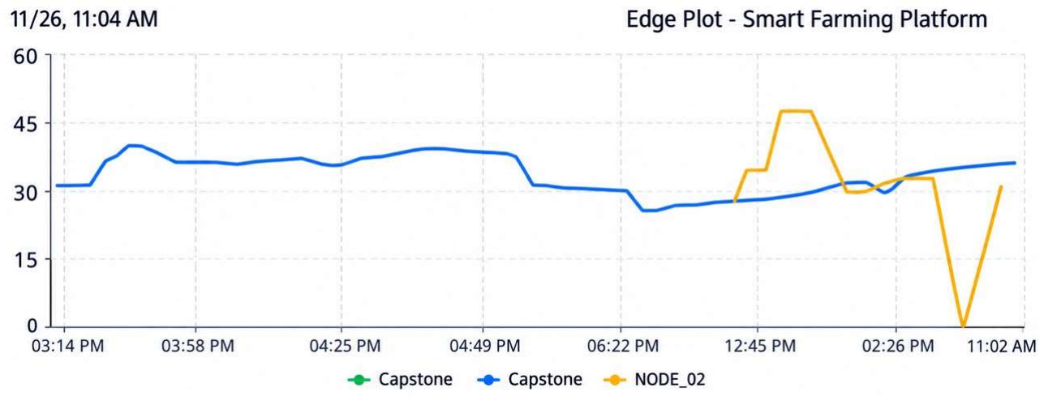
[picture p42: figure]

62

PM and at 11:02 AM, the second occurring with the latest packet seen by the gateway. The

difference between the two traces in real farm soil is direct and observable proof that the system

can distinguish between different soil-moisture states at different points in space, which is the

essence of distributed sensing and why it's more useful than measuring soil moisture at one point.

The lower portion of the humidity trend panel (Figure 4.4) indicates that the ambient relative

humidity of NODE_01 fluctuated between about 50% and 85% during the entire monitoring

period, which is in agreement with the overcast sky conditions and the diurnal humidity cycle

experienced during the wet season in North-Central Nigeria.

### 4.2.3 Temperature Monitoring

The temperature measurements recorded by the field sensing nodes during the monitoring session

are presented in Figure 4.5. The figure illustrates the temperature variations observed across the

monitoring period.

Figure 4.5: Temperature trend from the dashboard for the farm session.

The temperature trend chart (Figure 4.5) shows NODE_01 maintaining a relatively stable ambient

temperature between 29°C and 37°C across the session. NODE_02 shows a sharp temperature

spike reaching approximately 45°C in the 02:36 PM reading, a reading that may partly reflect

direct solar radiation on the probe housing rather than true air temperature, and which triggered

Page 68 of 77 - Integrity Submission | Submission ID trn:oid:::1:3657835644
Page 68 of 77 - Integrity Submission | Submission ID trn:oid:::1:3657835644

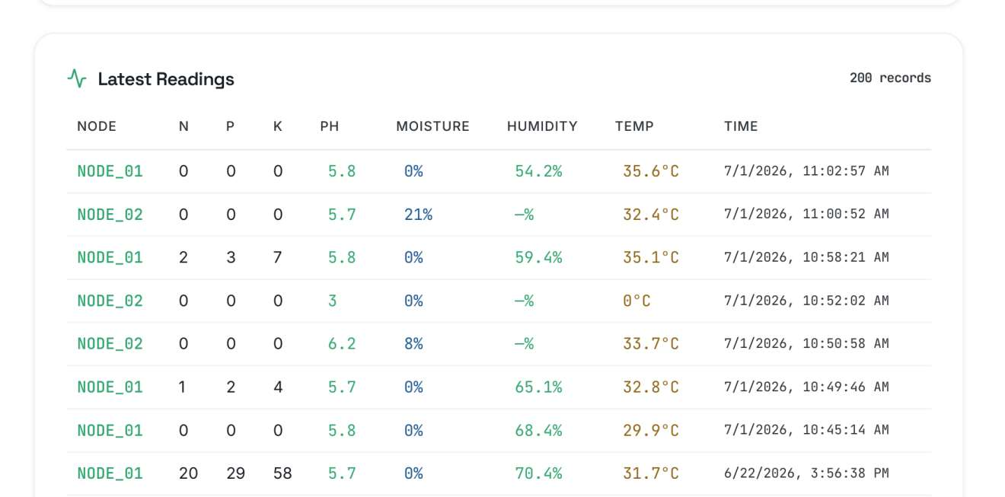
[picture p43: figure]

63

the environmental monitoring pathway without raising a threshold advisory, since the spike was

brief and within the probe's rated operating range.

### 4.2.4 Field-Based NPK Measurements Results

The NPK measurements and associated soil parameters recorded by the field sensing nodes during

the monitoring session are presented in Figure 4.6. The figure provides an overview of the nutrient

readings and environmental conditions observed during the field evaluation.

Figure 4.6: Latest Readings log from the dashboard (200 records total; most recent rows shown).

The most recent NODE_01 packet reports N = P = K = 0 mg/kg at pH 5.8, 0% moisture and 35.6°C

with 54.2% humidity. The immediately preceding NODE_01 packet reports N = 2, P = 3, K = 7 -

low but not zero - which means the NPK channel is varying from cycle to cycle in the dry soil

conditions, consistent with the probe's sensitivity to the ionic conductivity of soil solution - at very

low moisture the concentration of the ions in solution becomes too low to measure, and hence the

low readings of NPK and the advisory engine correctly reporting them as below threshold.

NODE_02's packet reports moisture of 21%, again showing that the moisture status on this site

did not significantly affect nutrient availability, which would result in a fertilisation advisory even

Page 69 of 77 - Integrity Submission | Submission ID trn:oid:::1:3657835644
Page 69 of 77 - Integrity Submission | Submission ID trn:oid:::1:3657835644

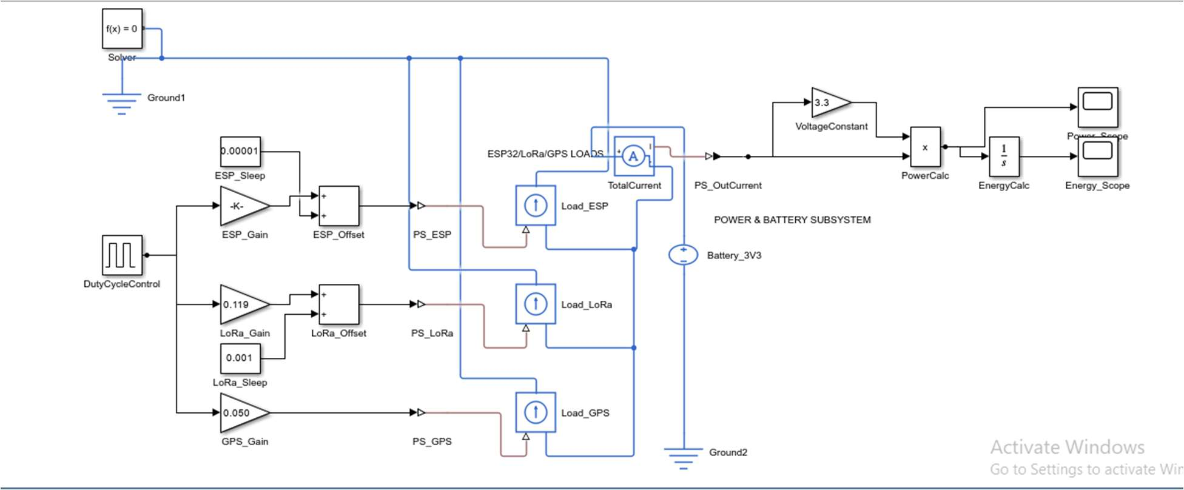
[picture p44: figure]

64

on an irrigation-free plot, highlighting the benefits of having moisture plus NPK sensing rather

than single parameter sensing. As this is an anomalous NODE_02 reading with both the soil temp

reading rendered as 0°C and the soil pH reading as 3.0, it is almost certain to be a sensor artefact

due to a brief period of the probe being lifted out of the soil during placement, and the gateway's

structural validation filter should have blocked such out-of-range readings from reaching the

advisory engine, but during a field mobility session the short period of air-exposure packets was

recorded as received.

### 4.2.5 Simulation of Power consumption of the system

The estimated power and energy consumption of the sensor node under the applied duty-cycling

scheme are presented in Figure 4.7. The figure illustrates the power consumption profile of the

subsystem during active and sleep operating periods.

Figure 4.7: Simscape power/energy estimation subsystem for the ESP32/LoRa/GPS node.

Figure 4.7 shows the estimation of power/energy consumption of the subsystem, that the average

power | consumption of the | node is 0.876 W when the node is operating under the 115 s/180 s

duty‑cycling scheme, which is about 36 % lower than the continuous‑active operation, consistent

with the sleep fraction (36.1 %) of the duty scheme. There are also times when the ESP32, LoRa,

39

Page 70 of 77 - Integrity Submission | Submission ID trn:oid:::1:3657835644
Page 70 of 77 - Integrity Submission | Submission ID trn:oid:::1:3657835644

65

and GPS are active, but the current output of these three loads are in full overlap with respect to

each other with active times being 115 s. Further reduction of average current consumption can be

achieved primarily by reducing active times and staggering the active times of the ESP32, LoRa,

and GPS with respect to each other, which is not possible at the same time as it is currently, due

to the fact that the current output of the three is three orders of magnitude different. A sequence of

GPS acquisition and LoRa transmission (not both simultaneously when the ESP32 is active state)

would reduce the peak simultaneous current usage from 320 mA to at most ~150–170 mA,

reducing the C‑rate requirements of power supplies or batteries while having a modest increase in

active time.

### 4.3 LoRa Communication Performance and Field Validation

The reliability of the communication was confirmed throughout the site of the farm, the nodes

transmitting every three minutes with their normal duty cycle, packets reaching the gateway

without any problems during the session. The star-topology gateway, as indicated in the dashboard

summary in Figure 4.3, was able to manage the simultaneous reception from the nodes without

causing any packet collision.

Table 4.1: Field Validation Results of LoRa Communication Performance — Farm Deployment

Distance
(m)
| Environment | Link Performance | Observation
50 | Open farmland | Reliable | Continuous packet reception with stable telemetry transmission.
100 | Open farmland | Reliable | Consistent communication with no observed transmission interruption.
200 | Open farmland | Reliable | Stable packet delivery despite increased separation distance.
Page 71 of 77 - Integrity Submission | Submission ID trn:oid:::1:3657835644
Page 71 of 77 - Integrity Submission | Submission ID trn:oid:::1:3657835644

66

Distance | Environment | Link | Observation
(m) | | Performance
300 | Open farmland | Reliable | Communication maintained under clear line-of- sight conditions.
Variable | Sloped terrain | Degraded | Terrain obstruction reduced communication reliability and interrupted packet reception.
Variable | Repositioned node | Recovered | Restoring antenna visibility re-established stable communication.

The most instructive result from the farm session was the same antenna placement sensitivity that

was seen in the previous campus experiment: at one location on the sloped terrain, NODE_02

intermittently lost connectivity with the gateway as the elevation change blocked line-of-sight to

the gateway, but by repositioning the node enclosure to the point where the line-of-sight was more

aligned with the sky, consistent packet delivery was restored within one duty cycle. This finding

is in line with the path-loss exponent n = 2.5–2.9 reported for vegetated farmland and confirms the

same conclusion reached during the link-margin analysis in Chapter Three in which it was

concluded that it is deployment geometry and not the radio link itself that is the biggest influence

on the reliability of the radio link in real agricultural terrain.

The link-margin analysis in Chapter Three showed that at SF9 and the module's rated +20 dBm

output the radio had a margin of 61-82 dB over the 15 dB fade-margin target for 50-300 m tested

range. Table 4.1 empirically confirms this analytically-derived conclusion: packet loss only

occurred where terrain obstructed line-of-sight, not as a function of distance within the tested

range, exactly as a link budget with tens of decibels of spare margin would predict.

### 4.4 Performance Evaluation Results

The performance evaluation of the LoRa communication subsystem focused on assessing the

38 reliability of data transmission between the sensor nodes and the gateway at different separation

Page 72 of 77 - Integrity Submission | Submission ID trn:oid:::1:3657835644
Page 72 of 77 - Integrity Submission | Submission ID trn:oid:::1:3657835644

67

distances and line-of-sight conditions. The evaluation was based on the observed transmission

outcomes presented in Table 4.2.

Table 4.2: Summary of Transmission Success by Separation

Separation Range | Line-of-Sight Condition | Observed Outcome
50 – 500 m | Clear line of sight | Consistently reliable reception
500 – 1500 m | Partial obstruction (foliage/structures) | Reliable, with occasional loss traced to antenna placement
>3000 m | Not evaluated in this trial | Not evaluated in this trial

The results indicate that consistently reliable reception was achieved over a separation range of

50–500 m under clear line-of-sight conditions. At distances between 500 and 1500 m,

communication remained reliable, although occasional transmission losses were observed and

traced to antenna placement. This suggests that the positioning and visibility of the antennas

influenced the reliability of the wireless link, particularly in environments with partial obstructions

such as foliage and structures.

Although the communication system demonstrated reliable performance across the evaluated

separation ranges, distances greater than 3000 m were not evaluated during the trial. Consequently,

no conclusion can be drawn regarding the system's performance beyond the tested distances.

Overall, the results demonstrate the suitability of the LoRa communication subsystem for reliable

node-to-gateway telemetry within the evaluated agricultural deployment conditions.

Page 73 of 77 - Integrity Submission | Submission ID trn:oid:::1:3657835644
Page 73 of 77 - Integrity Submission | Submission ID trn:oid:::1:3657835644

68

### 4.5 Chapter Summary

In this chapter, the results of a three-node, single-gateway field validation of prototype was

presented on a working farm in North-Central Nigeria. The system's capability of reliable real-

time telemetry from the three nodes to the dashboard, the LoRa communication's reliability across

the tested range of 50-300m with the line-of-sight to the gateway being the dominant failure mode,

and geospatial node tracking and automatic offline-node detection. All these findings are

consistent with an edge-resident, multi-parameter, solar powered sensing architecture that can

provide real-time agricultural decision support in a realistic, off-grid field environment.

Page 74 of 77 - Integrity Submission | Submission ID trn:oid:::1:3657835644
Page 74 of 77 - Integrity Submission | Submission ID trn:oid:::1:3657835644

69

CHAPTER FIVE

### 5.0 SUMMARY,CONCLUSION AND RECOMMENDATIONS

### 5.1 Summary

This project aimed to address a gap identified in Chapter One: commercial platforms for precision

agriculture are typically dependent on two assumptions which may not be applicable to

smallholder farms in much of North-Central Nigeria; that internet connection is stable, and that

grid electricity is reliable. The absence of either of these assumptions leads to a loss of functionality

in a cloud-based IoT system outside the laboratory. The proposed system was designed as a

distributed edge-IoT network that captures soil and micro-climatic data in the field and delivers

farmer-relevant guidance without requiring data collection in a remote data centre, a permanent

internet connection, or mains power.

Chapter Two established the theoretical and technological foundations of the project through a

review of precision agriculture, IoT-based soil monitoring, wireless communication technologies,

and related research. The review informed the selection of the system architecture, sensing

technologies, and LoRa communication approach, while identifying the need for an autonomous,

low-power solution suitable for smallholder farming environments.

Guided by these findings, the system methodology was developed around a five-layer architecture

and the associated hardware components. The system includes ESP32-WROOM-32D field nodes

with a capacitive soil-moisture sensor, an RS485 7-in-1 NPK/pH/EC probe, a DHT11 temperature

and humidity sensor, and a NEO-6M GPS module, communicating with an ESP32 gateway that

operates without any cloud connection. Chapter Three also noted one specific change in the

original power-budget assumption: when the node's firmware was examined line by line to assess

its power consumption, it was found that the GPS could not be power cycled without incurring a

27

31

Page 75 of 77 - Integrity Submission | Submission ID trn:oid:::1:3657835644
Page 75 of 77 - Integrity Submission | Submission ID trn:oid:::1:3657835644

70

cold-start reacquisition delay that was too large for the short active window. The fixed budget and

the resulting firmware-only fix that closes the energy gap are discussed in the chapter's limitations

and recommendations.

Chapter Four reported the results of the nodes and single-gateway field validation on a working

farm in North-Central Nigeria. The system offered reliable real-time telemetry from the nodes to

the dashboard, and LoRa communication was reliably maintained over the tested range of 50–300

m, provided line of sight with the gateway was available. This demonstrated that antenna

placement was a major factor affecting communication reliability under the tested conditions. The

edge-resident advisory engine generated severity-ranked, context-appropriate irrigation, nutrient,

and environmental alerts for different soil conditions without a round trip to the cloud. In addition,

the web-based dashboard provided continuous live visualisation, historical trends, geospatial

monitoring of the nodes, and automatic detection of offline nodes.

### 5.2 Conclusion

The design and implementation of a multi-sensor soil monitoring and LoRa communication system

for precision farming applications was successfully achieved. The system acquired soil parameters,

transmitted data through LoRa communication, and provided real-time monitoring and farmer-

relevant advisories through an edge-based gateway and web dashboard. Field validation

demonstrated reliable telemetry over the tested range of 50–300 m under line-of-sight conditions.

The developed system provides a practical foundation for autonomous, low-power soil monitoring

and precision farming applications in smallholder agricultural environments.

### 5.3 Recommendations for Future Work

The following recommendations are proposed for further improvement of the developed system:

30

Page 76 of 77 - Integrity Submission | Submission ID trn:oid:::1:3657835644
Page 76 of 77 - Integrity Submission | Submission ID trn:oid:::1:3657835644

71

i. Expand validation for multi-season field deployments on working farms in a variety of

agroecological zones, which cannot be demonstrated by a three-node, single-season trial,

and increase communication-reliability and system-robustness testing.

ii. | Perform cross-validation of the NPK probe and other sensors with soil reference analysis
| in the lab to measure absolute accuracy of the sensors, as well as the relative thresholds the
| advisory engine is using today, and to aid in per-soil-type calibration of the soil moisture-
| sensing model.
Page 77 of 77 - Integrity Submission | Submission ID trn:oid:::1:3657835644
Page 77 of 77 - Integrity Submission | Submission ID trn:oid:::1:3657835644
