Abdulrahuf7775/FinalYearProject/Operating_manual/Abdulrauf_Operating_manual.docx

Hardware Operating Manual

1. Starting the Node

Insert the 7-in-1 RS485 soil probe fully into the soil (no air gap around the tip).

Place the enclosure (ESP32 + battery + GPS + LoRa) above ground, on a raised or open spot.

Power on — the node runs on its solar-charged battery automatically; no manual switch-on is required once wired.

The node then repeats a fixed cycle every 3 minutes: wake → take readings → get GPS fix → send one LoRa packet → sleep.

2. GPS Locking

Make sure the enclosure has a clear, open view of the sky — GPS will not lock under thick foliage, metal cover, or indoors.

On first power-up (cold start), allow the module time to lock onto satellites before expecting a valid position.

On later wake-ups (warm start), the lock is faster since the last position/time is already known.

A successful lock is confirmed when the packet received at the gateway carries a valid latitude/longitude instead of blank values.

If no lock is obtained, move the enclosure to a more open position and allow another duty cycle (~3 minutes) for it to retry.

3. LoRa Positioning

Mount the enclosure/antenna above ground level (e.g. on a raised mound) — do not lay it flat on the soil.

Point the antenna upward and orient the enclosure so nothing tall (ridges, foliage, structures) blocks the path to the gateway.

Where possible, keep a line-of-sight to the gateway; the link tolerates light obstruction but not a fully blocked path.

If packets are not reaching the gateway, reposition the enclosure slightly for a clearer sky/gateway-facing view — reception typically recovers within one 3-minute cycle.

Field-tested LoRa range (SX1278, SF9, 125 kHz, +20 dBm):

4. Confirming the Node Is Working

Open the gateway dashboard.

Check the node shows as "online" with recent soil-parameter readings and a valid GPS position.

If the node shows "offline" or readings are missing, re-check probe insertion, enclosure sky view, and antenna position.

5. Quick Checklist

Probe fully inserted in soil, no air gap.

Enclosure mounted above ground with open sky view.

Antenna upright, no obstruction toward gateway.

GPS lock confirmed (valid lat/long on dashboard).

LoRa packets received reliably on the dashboard.
